netkot/EQ2_mount/Pinout-of-Circuit-TMC2209.webp

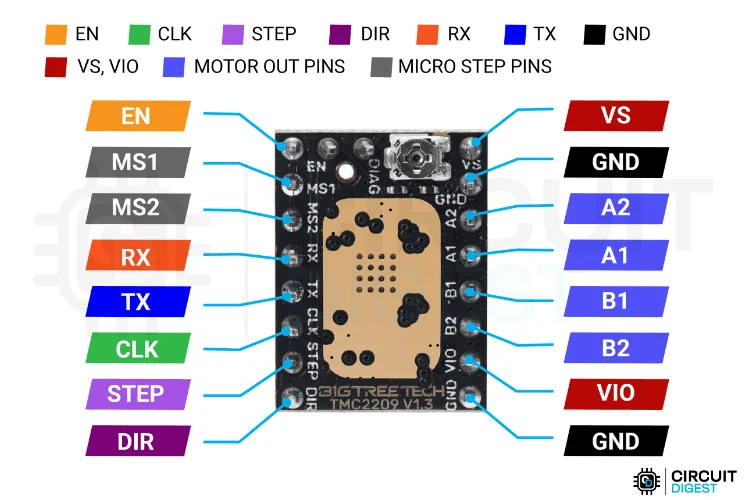
Pinout-of-Circuit-TMC2209.webp
