netkot/EQ2_mount/photo_2026-08-16_16-16-36.jpg

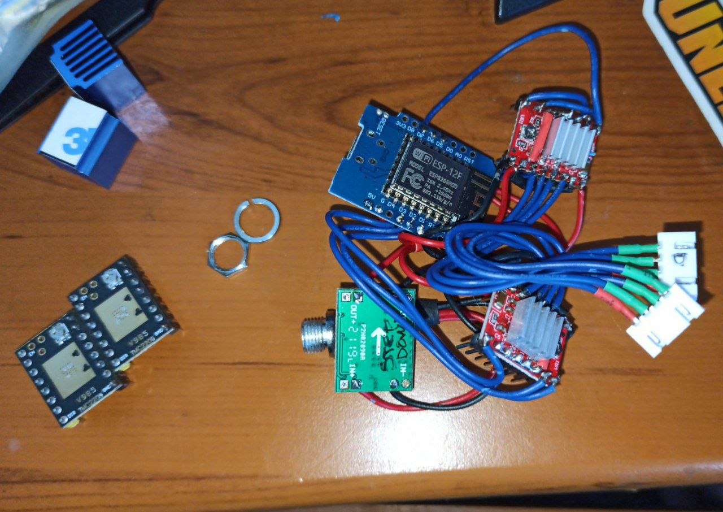
photo_2026-08-16_16-16-36.jpg
