netkot/EQ2_mount/HALL_SENSOR_DEC_HOME.md

# Датчик Холла A3144 — метка парковки по оси DEC

Цифровой датчик Холла отмечает положение оси DEC в **зоне парковки**. По нему прошивка
сама находит, где стоит ось, и поправляет счётчик DEC: после включения, после
сдвига оси рукой и т. п. Разделы 1–7 описывают железо, раздел 8 — прошивку.

Магнит стоит не в Home (труба на полюс, DEC = 90°), а в положении парковки:
механический DEC середины зоны 71.00° (калибровка 2026-10-31 по Sync на антенну).

**Датчик:** маркировка «3144 / 402». Это A3144 (Allegro или клон), а «402» — код
партии или даты. Тип: цифровой, униполярный, выход «открытый коллектор».

---

## 1. Выбор пина ESP8266

Занятые пины прошивки:

| GPIO | NodeMCU | Назначение |
|---|---|---|
| 4, 5, 0 | D2, D1, D3 | RA STEP / DIR / EN |
| 12, 14, 13 | D6, D5, D7 | DEC STEP / DIR / EN |
| 2 | D4 | TMC2209 UART |

Свободные пины:

| GPIO | NodeMCU | Годится? | Почему |
|---|---|---|---|
| **16** | **D0** | **Да, основной вариант** | Не участвует в загрузке и ни с чем не делит линию |
| 3 | RX | Да, запасной вариант | Есть `INPUT_PULLUP` и прерывания, но на линии висит USB-UART |
| 15 | D8 | **Нет** | Бут-пин: при старте должен быть LOW, а подтянутый датчик даёт HIGH, и плата не загрузится |
| A0 | A0 | Нет | Аналоговый вход, нужен только для линейного датчика (49E) |

### Особенности GPIO16 (D0)

- **Внутренней подтяжки к питанию нет.** GPIO16 относится к RTC-блоку и умеет только
  подтяжку к земле (`INPUT_PULLDOWN_16`). Вызов `pinMode(16, INPUT_PULLUP)` ядро
  Arduino просто игнорирует, и вход остаётся висящим в воздухе.
  **Поэтому внешний резистор 10 кОм к 3.3 V обязателен.** В коде пин настраивается как `pinMode(16, INPUT)`.
- **Прерываний нет.** Пин опрашивается в `loop()`. Этого достаточно: края зоны
  замеряются на 1°/с ≈ 44 шаг/с. Задержка `loop()` ошибки не даёт: мотор шагает из
  того же `loop()` и на время задержки тоже стоит.
- На некоторых NodeMCU к D0 подключён светодиод (возле USB, анод через резистор на
  3.3 V). Он слегка подтягивает линию вверх и загорается при срабатывании датчика,
  что удобно для отладки. Подтяжку он **не заменяет**, а на части плат его нет.

### Если всё же RX (GPIO3)

- Внешний резистор не нужен: `pinMode(3, INPUT_PULLUP)`.
- В прошивке перевести UART в режим только передачи:
  `Serial.begin(115200, SERIAL_8N1, SERIAL_TX_ONLY)`. Прошивка обновляется по OTA,
  поэтому приём по UART не нужен.
- При подключённом USB чип USB-UART держит RX в HIGH через 470 Ом. Датчик это
  перетянет (ток около 7 мА, A3144 выдерживает до 25 мА), но схема менее чистая.

---

## 2. Цоколёвка A3144 (TO-92)

Датчик держать скошенной стороной с надписью к себе, ножками вниз:

```
      ┌─────────┐
      │  3144   │
      │  402    │
      └─┬──┬──┬─┘
        1  2  3
       VCC GND OUT
```

---

## 3. Схема подключения

```
   +5V (Vin NodeMCU) ──┬──── 1 VCC
                       │
                    100 нФ   (у самого датчика)
                       │
   GND ────────────────┴──── 2 GND

                             3 OUT ──┬─────────┬──── D0 (GPIO16)
                                     │         │
                                  10 кОм     100 нФ  (у ESP, по желанию)
                                     │         │
                                   3.3V       GND
```

| Ножка | Куда |
|---|---|
| 1 VCC | +5 V (Vin NodeMCU) |
| 2 GND | GND |
| 3 OUT | D0 (GPIO16) и резистор 10 кОм к **3.3 V** |

### Важно

- [ ] **Питание датчика: 5 V, не 3.3 V.** A3144 работает от 4.5–24 V. От 3.3 V
      он либо не включится, либо будет срабатывать нестабильно.
- [ ] **Подтяжка: только к 3.3 V, не к 5 V.** Выход с открытым коллектором сам
      напряжение не выдаёт, он только замыкает линию на землю. Уровень HIGH задаёт
      резистор, и при подтяжке к 3.3 V на пин ESP 5 V не попадёт. ESP8266 официально не рассчитан на 5 V на входе.
- [ ] **Все конденсаторы 100 нФ керамические**, не электролитические: маркировка «104»
      (советская «Н1», «М1» или «0,1»), напряжение от 16 V. Полярности у них нет.
      Электролит на высоких частотах плохо давит помехи. Допустим разброс 47–220 нФ.
      При длинном проводе питания можно добавить у датчика электролит 10–47 мкФ / 16 V
      параллельно керамике (плюс к VCC). Керамику 100 нФ при этом не убирать.
- [ ] Конденсатор 100 нФ VCC–GND ставить прямо у датчика.
- [ ] Конденсатор 100 нФ OUT–GND у ESP нужен, если провод длинный или идёт рядом с
      проводами моторов (ШИМ драйверов TMC2209 наводит помехи).
- [ ] Для длинного провода лучше витая пара или экран: OUT в паре с GND. Не вести
      его в одном жгуте с фазами моторов.

### Длина провода

Скорость сигнала тут не важна: датчик переключается редко, а провод ёмкостью около 100 пФ/м
с подтяжкой 10 кОм даёт фронт в единицы микросекунд даже при 3 м. Падение напряжения
питания тоже не проблема, датчик потребляет около 5 мА. Ограничивают длину только
**наводки от моторов** и шум по земле.

| Длина | Что нужно |
|---|---|
| до 1 м | Обычные провода, схема как выше. На монтировке обычно столько и нужно |
| 1–3 м | Витая пара (OUT + GND), конденсатор 100 нФ OUT–GND у ESP обязателен, подтяжку уменьшить до 4.7 кОм |
| 3–5 м | Экранированный кабель (экран на GND только со стороны ESP), подтяжка 2.2–4.7 кОм, RC-фильтр: 1 кОм последовательно в OUT перед D0 и 100 нФ на землю у ESP |
| больше 5 м | Не рекомендуется: нужна гальваническая развязка (оптрон) или датчик ближе к плате |

**Какой кабель.** Для 1–1.5 м подходит обычный телефонный:
- **Плоская «лапша», 4 жилы:** подходит. Она гибкая, многопроволочная и нормально
  переносит изгибы при вращении RA. Порядок жил: `OUT – GND – VCC – GND`, то есть
  сигнал рядом с землёй, а четвёртая жила тоже на GND (обе земли спаять на обоих концах).
- **Витая пара (UTP cat3/cat5):** подходит и защищает от помех лучше (OUT + GND в одной
  паре, VCC + GND в другой). Но жилы у неё обычно однопроволочные: на подвижном
  участке они ломаются от изгибов. Её стоит брать для неподвижной прокладки или
  в многопроволочном варианте (патч-корд).
- **Витой шнур трубки:** не годится. Жилы из мишурной нити, их трудно паять, и они рвутся.
- Жилы бывают из омеднённого алюминия (CCA): их сложно паять. Медь видна по цвету на срезе.

Ещё два правила:
- Провод датчика не вести в одном жгуте с фазами моторов. Если пересекаются, то под прямым углом.
- Программный антидребезг в прошивке: срабатыванием считается уровень, который
  продержался 5 мс (`HALL_DEBOUNCE_MS`).

### Логика

| Состояние | Уровень на D0 |
|---|---|
| Магнита нет | HIGH (около 3.3 V) |
| Южный полюс у датчика | **LOW** (около 0.1–0.2 V) |

Логика инверсная: срабатывание даёт `digitalRead(16) == LOW`.

---

## 4. Если датчик на платке модуля (KY-003 и подобные)

У модулей со светодиодом и тремя штырьками на плате часто стоит своя подтяжка OUT→VCC
(10 кОм). При питании модуля от 5 V на D0 тогда придёт **5 V**.

- [ ] Мультиметром (режим сопротивления, без питания) проверить, есть ли резистор
      между OUT и VCC модуля.
- [ ] Если есть: **выпаять его** и поставить свою подтяжку 10 кОм к 3.3 V по схеме
      выше. Другой вариант — делитель на выходе: 10 кОм последовательно и 20 кОм на землю.
- [ ] Светодиод модуля можно оставить. Он висит со стороны VCC и линию не портит.
- [ ] Питать модуль от 3.3 V нельзя: на нём тот же A3144 (минимум 4.5 V).

---

## 5. Механика: магнит и крепление

- **Магнит:** неодимовый, около 5×2 мм (диск). Крепится на **вращающуюся** часть
  оси DEC (большую шестерню, фланец или ось), датчик — на **неподвижный** корпус.
- **Полярность:** A3144 униполярный и срабатывает **только от южного полюса**,
  направленного на сторону корпуса с надписью. Северный полюс он не видит.
  Если реакции нет, переверните магнит.
- **Зазор:** 2–4 мм. С магнитом 5×2 мм датчик уверенно срабатывает примерно до 3–5 мм.
  Ближе — надёжнее, но не допускать касания при люфте оси.
- **Положение:** датчик срабатывает в **положении парковки**. Механический DEC середины
  зоны — метка, хранится во флеше и измеряется калибровкой (раздел 8). Магнит можно
  ставить в любое положение: после перестановки достаточно заново откалибровать метку.
- **Зона срабатывания:** у датчика гистерезис включения и выключения, поэтому зона
  широкая. На EQ2 она вышла **около 21.5°** по оси DEC (вход около 60.6°, выход около 82.2°
  механически). Точность задаётся не размером зоны, а методикой поиска: середина между
  краями (разделы 6 и 8). Повторяемость середины — около 0.1°.
- **Ось DEC проходит 360°,** и магнит встречается один раз за оборот. Положение
  внутри одного оборота определяется однозначно. Но с какой стороны искать магнит
  и на каком обороте ось (перекрутка кабелей), один датчик не скажет: см. раздел 6.
- Магнит закрепить надёжно (эпоксидка или цианакрилат в выборке), чтобы он не
  сместился: иначе уплывёт метка.
- Рядом с датчиком не должно быть стальных деталей, которые искажают поле, и других магнитов.
- Мотор DEC (шаговый, с постоянными магнитами) держать подальше от датчика: хотя бы
  на 3–4 см.

### Ориентация датчика и магнита

Датчик реагирует только на поле, которое входит в его **плоскую сторону с надписью**,
и только на **южный полюс**. Поэтому магнит должен проходить мимо этой стороны,
глядя на неё южным полюсом.

**Датчик:**
- Чувствительный элемент находится под надписью, примерно в центре корпуса и на глубине
  около 0.5 мм от лицевой стороны.
- Сторона с надписью смотрит на путь магнита. Скошенная задняя сторона смотрит от магнита.
- Как повернуть корпус вокруг этой оси (ножками вдоль движения или поперёк), почти не важно.
  Удобнее ставить ножками поперёк движения: тогда магнит проходит над центром корпуса.

**Магнит:** обычный диск намагничен по оси, то есть его полюса находятся на плоских сторонах.
Значит, к датчику он должен быть обращён **плоской стороной, южным полюсом**, а не ребром.

**Монтаж на оси DEC: магнит проходит мимо датчика.** Магнит движется параллельно лицевой
стороне датчика, а не надвигается на неё в лоб. Подойдут два варианта:

```
 А) Магнит на торце шестерни/фланца       Б) Магнит на ободе (по радиусу)

      ось DEC                                    ось DEC
        │                                           │
   ═════╪═════  ← шестерня                     ┌────┴────┐
        │   [S]  ← магнит, S к датчику         │    ●    │ ← фланец
        │  ─────  зазор 2–3 мм                 └───[S]───┘ ← S наружу
        │  [▓▓▓]  ← датчик, надпись к магниту       ───    зазор
        │                                          [▓▓▓]   ← надпись к оси
```

- **А (торец):** магнит вклеен в торец шестерни или фланца, датчик стоит параллельно
  торцу. Проще выдержать зазор, если у оси нет осевого люфта.
- **Б (обод):** магнит на цилиндрической поверхности, датчик смотрит на ось. Зазор
  зависит от радиального биения.

Выбирайте тот вариант, где у оси меньше люфта именно в направлении зазора.

**Как найти южный полюс:**
- **Компасом:** поднесите магнит к компасу. Сторона магнита, к которой повернулся
  **северный** конец стрелки, и есть **южный** полюс. Пометьте её маркером.
- **Самим датчиком:** поднесите магнит одной стороной. Если `Hall` не меняется,
  переверните магнит.

**Проверка после установки:** проверните ось рукой через зону. Датчик должен включаться
и выключаться один раз за проход, без дрожания на краях (поле `hall_edges` в `/status`
растёт ровно на 2).

---

## 6. Сторона подхода, направление поиска и перекрутка на 360°

Датчик выдаёт один бит: «магнит рядом» или «нет». Ни направления движения, ни номера
оборота он не знает. Всё это прошивка берёт из своих данных.

### С какого края зоны подошли

Прошивка сама крутит мотор, поэтому в момент срабатывания знает направление
движения (знак скорости, пин DIR) и текущий счётчик шагов. Стороной подхода не нужно
«узнавать» — её надо **выбирать**. Методика:

1. Если при старте датчик уже LOW, выйти из зоны (например, в сторону `−`).
2. Медленно ехать в `+`. Шаг, на котором HIGH → LOW, — край A.
3. Проехать зону насквозь. Шаг, на котором LOW → HIGH, — край B.
4. Метка = (A + B) / 2.

Середина зоны не зависит от гистерезиса и от силы магнита, поэтому она повторяема.

### В какую сторону ехать искать

Это и есть настоящая неоднозначность: из произвольного положения до магнита можно
ехать в обе стороны, и сам датчик не подскажет, какая ближе. Варианты:

| Способ | Как работает | Минусы |
|---|---|---|
| **Подсказка по счётчику** (сделано) | Счётчик DEC после включения берётся из парковки во флеше. Ехать к метке и не дальше 30° за неё | Если ось провернули рукой, подсказка неверна → поиск не найдёт магнит в окне и остановится с ошибкой |
| Расширяющееся окно | ±N° в одну сторону, затем в другую, N растёт до предела | Медленно, но кабели не накрутятся |
| Флажок на 180° | Датчик видит «да» на половине оборота и «нет» на другой половине. Уровень сразу говорит, в какой половине оборота труба и куда ехать; метка — граница половин | Нужна дуга из магнитов или оптический щелевой датчик с полукруглым флажком |
| Две метки | Второй магнит или второй датчик под другим углом, как у квадратурного энкодера | Сложнее механика и прошивка |

### Перекрутка на 360°

**Один датчик полные обороты не различает в принципе.** При DEC = 71° и при 71° + 360°
труба физически стоит одинаково, разница только в том, как намотаны кабели. Защита:

- [ ] **Программный лимит механического DEC** — меньше 360° вокруг метки, например
      ±180°. GoTo и джог за пределы не выпускать. Пока прошивка непрерывно считает шаги,
      номер оборота однозначен.
- [x] **Положение DEC во flash** — это парковка: после перезагрузки счёт
      продолжается с неё.
- [x] **Окно поиска меньше 360°**: не дальше 30° за ожидаемую метку, чтобы при отказе
      датчика ось не сделала лишний оборот.
- [ ] Если ось провернули рукой при отпущенном фиксаторе или на выключенной монтировке, никакой
      датчик этого не увидит. Здесь нужен механический упор или визуальная проверка
      кабелей перед поиском.

**Для EQ2 сделано:** точечный магнит в зоне парковки, парковка во flash как подсказка,
поиск к метке с окном 30° за неё, середина по двум краям зоны. Программного лимита
±180° пока нет. Флажок на 180° нужен, только если нужен поиск «с нуля» без подсказки.

---

## 7. Проверка до прошивки

1. Подключить датчик по схеме, подать питание.
2. Мультиметром на D0 относительно GND:
   - без магнита — около **3.3 V**;
   - южным полюсом к надписи вплотную — около **0.1–0.2 V**.
3. Если всегда 3.3 V: проверить полярность магнита, питание 5 V на ножке 1 и
   цоколёвку (не перепутаны ли 1 и 3).
4. Если всегда около 0 V или напряжение плавает: нет подтяжки к 3.3 V или ошибка в схеме.
5. Если без магнита около 5 V: подтяжка идёт к 5 V (модуль, раздел 4). **Сразу отключить.**
6. Покрутить ось DEC вручную и убедиться, что в зоне парковки напряжение падает в LOW.

---

## 8. Прошивка

### Датчик

- `#define DEC_HOME_PIN 16`, `pinMode(DEC_HOME_PIN, INPUT)`: подтяжка внешняя.
- Антидребезг 5 мс; каждое переключение пишется в Serial вместе с механическим DEC.
- Поля в `/status`:

| Поле | Что значит |
|---|---|
| `hall` | 1 — магнит у датчика (после антидребезга) |
| `hall_raw` | мгновенный уровень на пине (1 = LOW) |
| `hall_edges` | число переключений с момента загрузки |
| `hall_in` / `hall_out` | механический DEC при последнем входе в зону и выходе из неё |
| `mech_dec` | текущий механический DEC |
| `hall_mark` | метка: механический DEC середины зоны |
| `homing` | этап поиска: 0 — нет, 1 — быстрый подход, 2 — отъезд из зоны, 3 — замер краёв, 4 — доезд в середину |
| `home_msg` | результат последнего поиска |

- В строке статуса веб-интерфейса: «Hall: MAGNET / clear (число переключений)» и
  «Датчик: …» с результатом поиска.

### Поиск метки

`GET /home-search[?dir=1|-1][&calibrate=1]`, кнопки «🧲 Привязка по датчику» и
«🧲 Калибровать метку» в карточке GoTo/Sync.

1. Направление — к метке по текущему счётчику DEC (`dir` задаёт его вручную). Из положения
   ниже метки по N-стороне это DEC+: труба поднимается.
2. Быстро (6°/с) до входа в зону. Не дальше 30° за метку, иначе ошибка
   «магнита нет в окне поиска».
3. Назад из зоны и ещё на 3° (если при старте датчик уже видит магнит — сразу этот этап).
4. Медленно (1°/с) насквозь через зону: край A на входе, край B на выходе.
   Середина = (A + B) / 2. Зона шире 30° — ошибка.
5. **Привязка:** счётчик DEC сдвигается так, чтобы середина стала равна метке.
   **Калибровка:** счётчик верен (только что был Sync), середина сохраняется во флеш
   как новая метка. В обоих случаях ось доезжает в середину зоны.

RA поиск не трогает. Stop, джог, Sync и E-Stop прерывают поиск. Метка по умолчанию —
`HALL_MARK_DEFAULT` (71.10°); калибровка записывает её во флеш (EEPROM, адрес 32,
после парковки).

### Порядок работы

- **Один раз (и после перестановки магнита):** Sync на антенну или звезду →
  «Калибровать метку» → Set Park (труба стоит на метке, парковка = метка).
- **Перед выключением:** Park, ось уходит на метку.
- **После включения:** счётчики берутся из парковки. «Привязка по датчику» поправит
  DEC, если ось сдвинулась. RA датчик не проверяет.

### Пока не сделано

- Программный лимит механического DEC ±180° от метки (раздел 6).
- Команды LX200 (`:hC#` и т. п.) для поиска метки.
