netkot/EQ2_mount/images/s-l1600.jpg

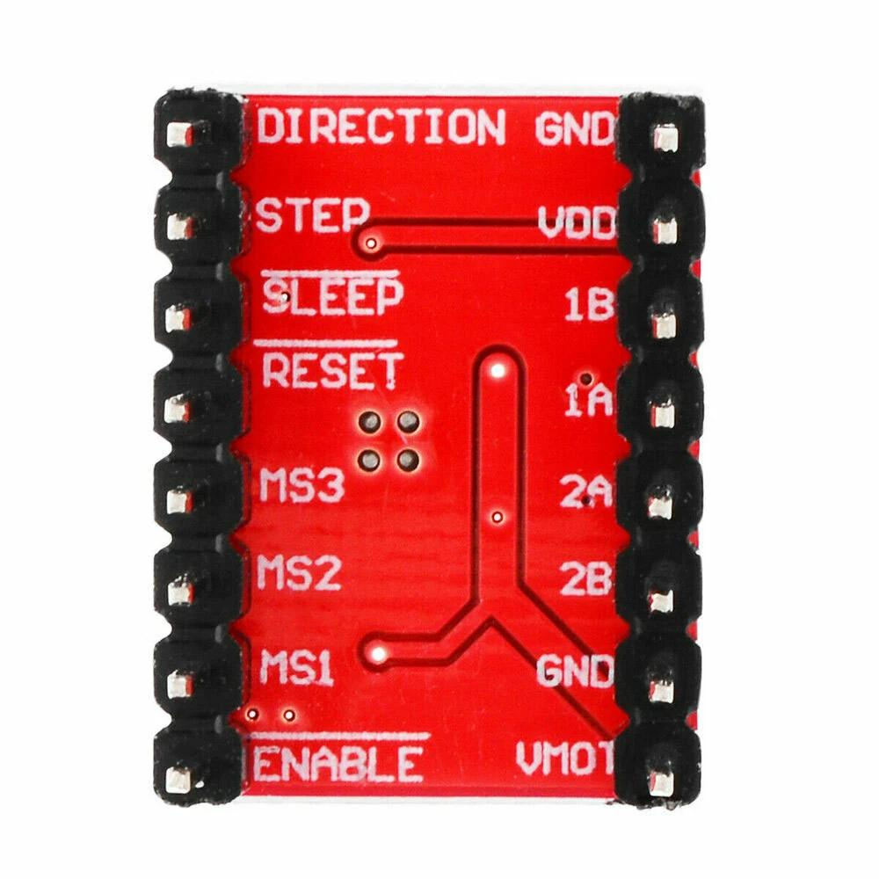
images/s-l1600.jpg
