netkot/EQ2_mount/images/screenshot 2026-08-16 212933.jpg

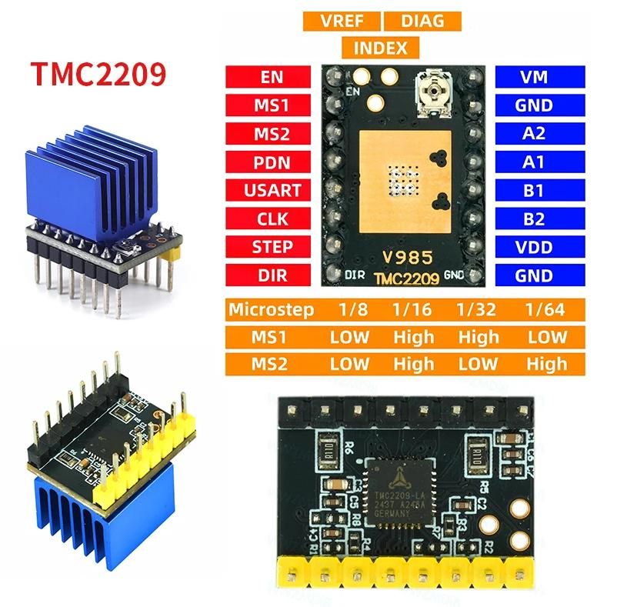
images/screenshot 2026-08-16 212933.jpg
