netkot/EQ2_mount/TMC2209_SOLDERING.md

# Перепайка A4988 → TMC2209 — пошаговая инструкция

Сопутствует разделу «План перехода на TMC2209» в `README.md`. Здесь — физика пайки:
какой провод со старого драйвера куда переносится на новый.

**Статус на 2026-10-17:** обе оси перепаяны и проверены (UART, ток, вращение моторов).

Распиновка платы ниже — **точная, с фото/схемы конкретно этой платы**
(«TMC2209», партия «V985», чип `TMC2209-LA`), а не обобщённая по формату Pololu.

---

## 0. Перед началом (обязательно)

- [ ] Полностью обесточить сборку — отключить 12V **и** USB/питание ESP. Не работать
      под напряжением.
- [ ] Сфотографировать текущую распайку каждого A4988 до разборки (на случай отката).
- [ ] Работать **по одной оси за раз**: полностью перенести RA, проверить, только
      потом браться за DEC — так нельзя перепутать, какой провод откуда.
- [ ] Свериться с маркировкой резистора Rsense на новой плате (должен быть 0.11 Ω,
      встречаются 0.1/0.15 Ω — влияет на формулу VREF/тока, см. README).

---

## Итоговая схема: Пин ESP → Пин драйвера (справочно)

Собранная в одном месте выжимка из разделов ниже — просто «откуда куда идёт провод».
Детали, объяснения и оговорки — в соответствующих разделах (2–4) по ссылкам в скобках.

### Сигнальные пины (STEP/DIR/EN) — по одному на ось, не общие

| Пин ESP (GPIO)  | Сигнал | Куда на драйвере |
|---|---|---|
| D2 (GPIO4) | STEP RA  | STEP на RA-драйвере |
| D1 (GPIO5) | DIR RA | DIR на RA-драйвере |
| D3 (GPIO0) | EN RA | EN на RA-драйвере (активный уровень — LOW) |
| D6 (GPIO12) | STEP DEC | STEP на DEC-драйвере |
| D5 (GPIO14) | DIR DEC  | DIR на DEC-драйвере |
| D7 (GPIO13) | EN DEC | EN на DEC-драйвере (активный уровень — LOW) |

### UART-шина — общая на оба драйвера (п.4.1)

| Пин ESP (GPIO) | Куда | Комментарий |
|---|---|---|
| D4 (GPIO2, RX+TX) | PDN на RA **и** PDN на DEC (общий узел) | через резистор **1 кΩ**, стоящий один раз до разветвления |
| D8 (GPIO15) | **никуда** | ⚠️ не подключать — ESP перестаёт загружаться (п.4.1) |

`USART`-пин на обеих платах никуда не подключается (см. п.4.1 — прозвонкой подтверждено,
что он не связан с PDN_UART на этой плате).

### Питание логики (VDD) и земля — общие на оба драйвера

| Откуда | Куда |
|---|---|
| 3.3V (даёт плата ESP-12F) | VDD на RA-драйвере и VDD на DEC-драйвере |
| GND (любой GND ESP) | GND (логический, рядом с VDD) на RA и на DEC |

⚠️ Не 5V — see п.3 в README и п.0/3 ниже, у ESP-12F логика 3.3V.

### Силовое питание (12V) — не через ESP, напрямую с рельса 12V

| Откуда  | Куда |
|---|---|
| 12V+ | VM на RA-драйвере и VM на DEC-драйвере |
| 12V GND  | GND (силовой, рядом с VM) на RA и на DEC |

### Перемычки на самой плате драйвера (не идут к ESP вообще)

Это не провода к ESP, а короткие перемычки прямо на плате каждого драйвера — упомянуты
здесь, чтобы схема была полной:

| Что | RA-драйвер | DEC-драйвер |
|-----|---|---|
| CLK | → GND (свой, на плате) | → GND (свой, на плате) |
| MS1 | → GND (адрес 0) | → VDD/3.3V (адрес 1) |
| MS2 | → GND (адрес 0) | → GND (адрес 1) |

Обмотки мотора (A1/A2/B1/B2) идут к мотору, а не к ESP — см. таблицу переноса в п.3.

---

## 1. Логическая схема A4988 (что перенести)

```
              A4988 (типовая схема функций Pololu-формата)
        ┌───────────────────────────┐
  EN ───┤ ENABLE            VDD     ├─── VDD (логика, обычно 3.3–5V — проверить!)
 MS1 ───┤ MS1               GND     ├─── GND (логика)
 MS2 ───┤ MS2               2B      ├─── обмотка мотора, конец 2B
 MS3 ───┤ MS3               2A      ├─── обмотка мотора, конец 2A
 RST ───┤ RESET             1A      ├─── обмотка мотора, конец 1A
 SLP ───┤ SLEEP             1B      ├─── обмотка мотора, конец 1B
STEP ───┤ STEP              VMOT    ├─── VMOT (12V, силовое питание мотора)
 DIR ───┤ DIR               GND     ├─── GND (силовой)
        └───────────────────────────┘
```

MS1/MS2/MS3/RESET/SLEEP на A4988 сейчас, скорее всего, либо не задействованы
(NC/подтянуты по умолчанию), либо запаяны в конкретное положение под полношаговый/
микрошаговый режим — эти провода **не переносим**, они на TMC2209 получают другой
смысл (см. ниже).

## 2. Точная схема этой платы TMC2209 (V985)

```
                     ┌───────┬───────┬───────┐
                     │ VREF  │ DIAG  │       │   (VREF — подстроечник, DIAG/INDEX — доп. пины)
                     └───────┴───┬───┴───────┘
                            INDEX│
        ┌────────────────────────┴─────────────────────┐
  EN ───┤ EN                                        VM ├─── VM (VMOT, 12V)
 MS1 ───┤ MS1 (адрес, бит0 в UART-режиме)          GND ├─── GND (силовой)
 MS2 ───┤ MS2 (адрес, бит1 в UART-режиме)           A2 ├─── обмотка мотора, катушка A (конец 2)
 PDN ───┤ PDN   ─┐  (см. п.4.1 — соединить          A1 ├─── обмотка мотора, катушка A (конец 1)
USART ──┤ USART ─┘   с USART перемычкой)            B1 ├─── обмотка мотора, катушка B (конец 1)
 CLK ───┤ CLK  → на GND (внутренний генератор)      B2 ├─── обмотка мотора, катушка B (конец 2)
STEP ───┤ STEP                                     VDD ├─── VDD (логика — ОБЯЗАТЕЛЬНО 3.3V!)
 DIR ───┤ DIR                                      GND ├─── GND (логика)
        └──────────────────────────────────────────────┘
```

Легенда с шелкографии платы (легаси-режим микрошага, актуален **только пока UART
не поднят** — после инициализации UART MS1/MS2 становятся адресными битами, а не
настройкой микрошага, см. п.4.2):

| Microstep | 1/8 | 1/16 | 1/32 | 1/64 |
|---|-----|---|---|---|
| MS1 | LOW | High | High | LOW  |
| MS2 | LOW | High | LOW  | High |

---

## 3. Таблица переноса «провод → провод»

| Провод (по факту в жгуте) | Со старого A4988 | На новый TMC2209 | Действие |
|---|---|---|---|
| Синий сигнальный (STEP) | STEP | STEP | 1:1 |
| Синий сигнальный (DIR) | DIR | DIR | 1:1 |
| Синий сигнальный (ENABLE) | ENABLE | EN | 1:1 |
| Красный (силовой, 12V) | VMOT | VM | 1:1 |
| Чёрный (силовой, рядом с VMOT) | GND (силовой) | GND (силовой, рядом с VM) | 1:1 |
| Зелёные JST-пары (обмотки мотора)  | 1A/1B/2A/2B (или разъём) | A1/A2/B1/B2 (или разъём) | Если на новой плате есть такой же JST-разъём, просто переставить разъём; если голые контактные площадки — впаять провода от мотора напрямую. **Полярность внутри пары (A1↔A2, B1↔B2) не критична — направление вращения потом правится в коде/DIR, а не перепайкой.** ⚠️ А вот **пары** проверять обязательно на выводах драйвера (п.6) — порядок контактов разъёма не обязан совпадать с порядком A2/A1/B1/B2. |
| Провод логического питания (VDD) | VDD | VDD | ⚠️ Переносить **только если источник провода 3.3V**. Если раньше шёл от 5V-рельса — перекинуть исток на 3.3V (у ESP-12F плата даёт 3.3V логику) |
| Чёрный (логический GND) | GND (логика) | GND (логика, рядом с VDD) | 1:1 |

MS1/MS2/MS3/RESET/SLEEP старого A4988 — эти провода никуда не переносим
(остаются неиспользованными/удаляются). На новой плате MS1/MS2 используются
заново под адресацию (п.4.2), CLK и PDN/USART — новые провода (п.4).

---

## 4. Новые провода (которых на A4988 не было)

### 4.1 UART-шина (общая для RA и DEC, однопроводная)

На этой плате PDN_UART выведен **двумя соседними пинами — `PDN` и `USART`**.
Проверено мультиметром (прозвонка/сопротивление, питание снято) — между `PDN` и
`USART` **нет связи («OL»)**, пины независимы. Вывод: `USART` в разводке этой
платы не подключён к сигналу PDN_UART (либо задействован под что-то иное/не
разведён вовсе). Используем только **`PDN`** как рабочий контакт UART, `USART`
никуда не подключаем.

⚠️ Проверено пока на одной плате — перед пайкой **второй** платы (RA/DEC — какая
из них уже проверена, стоит уточнить) стоит повторить прозвонку `PDN`↔`USART` и
на ней, на случай если платы из разных партий разведены по-разному.

Поскольку своего резистора на плате в этом случае нет, внешний резистор 1кΩ между
ESP и узлом — обязателен. ESP и передаёт, и принимает одним пином D4:

```
                                    ┌── PDN (RA-драйвер,  addr 0)
ESP D4 (GPIO2) ────[резистор 1кΩ]───┤
                                    └── PDN (DEC-драйвер, addr 1)

ESP D8 (GPIO15) — не подключён
```

- Резистор 1кΩ стоит один раз, между D4 и общим узлом.
- Оба драйвера (RA и DEC) висят на одном общем узле шины — на пине `PDN` каждого.
- `USART` на обеих платах остаётся неподключённым.
- ⚠️ **D8 к узлу не подключать.** В первой версии схемы RX шёл с D8 прямо на узел — узел
  подтянут вверх, GPIO15 при старте оказывался в HIGH, и ESP не загружался
  (`boot mode:(7,0)` / `waiting for host` в логе на 74880 бод, esptool не подключается).
  Если такое повторится — первым делом проверить, что D8 свободен.

Также обязательно **CLK → GND** на каждом драйвере (новый провод) — иначе пин
клока не определён и чип не запустится штатно на внутреннем генераторе.

### 4.2 Адресация MS1/MS2 (статическое подтягивание, отдельно на каждом драйвере)

| Драйвер | MS1 | MS2  | Адрес UART |
|---|---|---|---|
| RA | → GND | → GND | 0 |
| DEC | → VDD (3.3V) | → GND | 1 |

Это отдельные короткие перемычки на каждой плате TMC2209 (не идут к ESP напрямую).
Действуют только после инициализации UART — до этого MS1/MS2 = легаси-таблица
микрошага из п.2.

---

## 5. Порядок работы по оси (повторить для RA, затем для DEC)

1. [ ] Обесточить сборку.
2. [ ] Сфотографировать распайку старого драйвера этой оси.
3. [ ] Перепаивать **по одному проводу за раз** (отпаял → сразу припаял на новое
       место по таблице п.3) — не отпаивать всё разом, чтобы не перепутать провода
       между собой.
4. [ ] Проверить провод VDD отдельно — источник должен быть 3.3V, не 5V.
5. [ ] Если это вторая плата (ещё не прозванивалась) — прозвонить `PDN`↔`USART`
       мультиметром до пайки (п.4.1), убедиться что тоже «OL», как на первой.
6. [ ] Впаять перемычку `CLK`→`GND` на плате драйвера (п.4.1).
7. [ ] Добавить провод UART-шины от ESP D4 на пин `PDN` (п.4.1, резистор 1кΩ, D8 не трогать) —
       можно сразу развести общий узел на оба драйвера, даже если второй ещё не перепаян.
8. [ ] Добавить перемычки адреса MS1/MS2 (п.4.2) — GND/GND для RA, VDD/GND для DEC.
9. [ ] Если это тот драйвер, под который выделен запасной радиатор — приклеить его.
10. [ ] Прозвонить мультиметром **до подачи питания** (см. п.6 ниже).

---

## 6. Финальная проверка перед первым включением

Прозвонить мультиметром в режиме «прозвонка/сопротивление» (питание выключено!):

- [ ] Нет короткого VM ↔ GND.
- [ ] Нет короткого VM ↔ VDD.
- [ ] Нет короткого VDD ↔ GND.
- [ ] STEP/DIR/EN не закорочены на VM или на GND.
- [ ] VDD действительно приходит с 3.3V-рельса, не с 5V.
- [ ] MS1/MS2 каждого драйвера подтянуты согласно таблице в п.4.2 (не висят в воздухе).
      После включения проверить вольтметром относительно GND драйвера: у RA MS1 = 0 В,
      MS2 = 0 В; у DEC **MS1 = 3.3 В**, MS2 = 0 В. На DEC MS1 сначала оказался на 0 —
      оба драйвера отвечали по адресу 0 и мешали друг другу (README п.6, «Конфликт адресов»).
- [ ] CLK подтянут к GND (не висит в воздухе).
- [ ] Обмотки мотора не перепутаны между парами. Мерить **на выводах драйвера** с
      подключённым через разъём мотором: A1–A2 и B1–B2 ≈ сопротивление фазы
      (RA JK42HS40 ≈ 1.5–1.65 Ом, DEC JK42HS60 ≈ 6 Ом), A1–B1 — обрыв. Если пары
      перекрёстные — мотор дёргается на месте, а не вращается; лечится перестановкой
      двух средних проводов (A1 ↔ B1). Так было на RA: на разъёме мотора пары были
      правильными, а провода от разъёма к драйверу (все синие) перекрестились.
- [ ] Электролит **100 мкФ / ≥25 В** на VM–GND прямо у драйвера (полярность!). Без него
      драйвер может сбрасываться при включении мотора (видно по `/tmc`, см. README п.6).
- [ ] D8 ни к чему не подключён.

Первое включение — подавать питание аккуратно, держать руку на отключении первые
секунды. Мотор подключать и отключать **только при снятом 12V**.

Проверка после включения (прошивка уже с `TMCStepper`, см. README п.5–6):

1. Лог USB на 115200: `TMC RA: OK, версия 0x21, микрошаг 1/16, ток 1160 мА` (для DEC —
   `TMC DEC: OK …`, ток 840 мА). `нет ответа` — проверить D4, резистор, PDN, MS1/MS2.
   Без USB — `/status` (`ra_drv` / `dec_drv`) и `/tmc`. Если драйвер не отвечает —
   `/tmc-scan` покажет, кто на каком адресе и не закорочена ли линия.
2. Короткий jog на 0.1°/с (`/jog?axis=ra&speed=0.1`, стоп — `/stop-all`). `/tmc` читать
   до и после движения: `microsteps` должен оставаться 16, `ifcnt` — не меняться. Опрос
   `/tmc` во время движения сам вызывает рывки мотора — для проверки плавности не годится.
3. Мотор должен вращаться ровно и почти бесшумно (StealthChop).
