netkot/EQ2_mount/OneStep_Full_ESP8266_v6.ino

// ============================================================
//  EQ2 Mount Controller  —  v6.0
//  ESP8266 NodeMCU
//
//  Протоколы:
//    • Web UI        http://<IP>/
//    • RTS2 JSON API http://<IP>/api/...   (Stellarium)
//    • LX200/OnStep  TCP <IP>:4030         (KStars, PHD2, Cartes du Ciel)
//    • OTA update    http://<IP>/update
//
//  Изменения v6 vs v5:
//    • LX200/OnStep команды приведены в полное соответствие
//      с lx200driver.h (INDI) и OnStepListCmd.txt
//    • Добавлены: :ACK (0x06), :GX0n#, :GX4n#, :GX9n#,
//      :GX91#, :GXS#, :GXU#, :SXA#, :GXGA#, :GXGO#,
//      :GX98# (rotator none), PEC-заглушки :VH# :VR# :VS# :VW#,
//      Library-заглушки :LI# :LR# :LB# :LN# :LC# :LD# :LL# :Lo#,
//      :Rotator-заглушки :rA# и прочие :r*#
//    • Исправлены форматы ответов :GU# :Gu# :GW# per lx200driver
//    • :GT# → "60.1642#" когда трекинг включён, "0.0000#" иначе
//    • :D#  → "\x7f#" / "#" (per spec "\0x7f#")
//    • DEC мотор не отключается после остановки (держит ось)
//
//  v6.1: модель координат RA = LST − HA (NTP), стороны опоры,
//        GoTo с доводкой, трекинг/джог отделены от run() — см. README
// ============================================================

#include <ESP8266WiFi.h>
#include <ESP8266WebServer.h>
#include <AccelStepper.h>
#include <ElegantOTA.h>
#include <SoftwareSerial.h>
#include <TMCStepper.h>
#include <time.h>
#include <sys/time.h>
#include <coredecls.h>
#include <EEPROM.h>

// ============================================================
//  WiFi
//  Данные вынесены в secrets.h (не коммитить!). Шаблон: secrets.h.example
// ============================================================
#include "secrets.h"

// ============================================================
//  Пины драйверов TMC2209 (STEP/DIR/EN — как у A4988)
// ============================================================
#define RA_STEP_PIN    4
#define RA_DIR_PIN     5
#define RA_ENABLE_PIN  0

#define DEC_STEP_PIN   12
#define DEC_DIR_PIN    14
#define DEC_ENABLE_PIN 13

// Датчик Холла A3144 — концевик Home по DEC (см. HALL_SENSOR_DEC_HOME.md).
// У GPIO16 нет подтяжки к питанию: внешние 10 кОм к 3.3 V. LOW = магнит.
#define DEC_HOME_PIN   16

// ============================================================
//  Механика
// ============================================================
const int   MICROSTEPS     = 16;
const int   STEPS_PER_REV  = 200 * MICROSTEPS;   // 3200 шаг/об

// DEC: шестерни 2×10 = 1:5
const float DEC_GEAR_RATIO  = 5.0f;
const double DEC_STEPS_PER_DEG =
    (STEPS_PER_REV * DEC_GEAR_RATIO) / 360.0;   // 44.444 (не округлять — 1% ошибки)

// RA: ремень GT2 16→80 (×5) + червяк EQ2 (×144) = 1:720
const float RA_BELT_RATIO  = 80.0f / 16.0f;
const float RA_WORM_RATIO  = 144.0f;
const float RA_TOTAL_RATIO = RA_BELT_RATIO * RA_WORM_RATIO; // 720
const long  RA_STEPS_PER_DEG =
    (long)((STEPS_PER_REV * RA_TOTAL_RATIO) / 360.0f);   // 6400

// Сидерическая скорость
const float SIDEREAL_RATE     = 360.0f / 86164.0f;       // °/сек
const float RA_SIDEREAL_SPEED = SIDEREAL_RATE * RA_STEPS_PER_DEG;

// Инверсия направления (поменяйте знак если крутит не туда)
const int   RA_DIR  =  1;
const int   DEC_DIR =  1;

// Механический часовой угол оси RA в домашнем положении (противовес вниз,
// труба на полюс), градусы. −90: из дома DEC− опускает трубу на восток,
// +90 — на запад. На монтировке проверено: восток.
const double HOME_HA_DEG  = -90.0;
// GoTo ниже этой высоты над горизонтом не выполняется, градусы
const double GOTO_MIN_ALT = 0.0;
// Наземный ориентир для привязки без звёзд: антенна на 10 этаже соседнего
// дома (102.4 м, азимут 146.7°, высота 4.7° с 7 этажа, широта 50.46°).
// Неподвижен, поэтому задан часовым углом, а не RA: время не нужно.
const double LANDMARK_HA_DEG  = -38.23;   // к востоку от меридиана = 21h27m05s
const double LANDMARK_DEC_DEG = -27.85;   // −27°51′

// ============================================================
//  Объекты
// ============================================================
AccelStepper stepperRA (AccelStepper::DRIVER, RA_STEP_PIN,  RA_DIR_PIN);
AccelStepper stepperDEC(AccelStepper::DRIVER, DEC_STEP_PIN, DEC_DIR_PIN);
ESP8266WebServer server(80);

// ============================================================
//  TMC2209 UART — однопроводная шина на D4 (GPIO2) через 1 кОм
//  к общему узлу PDN_UART. Адреса: RA = 0, DEC = 1 (MS1/MS2).
// ============================================================
#define TMC_UART_PIN   2
const long  TMC_BAUD       = 57600;   // ≤74880 — асинхронный RX-ISR SoftwareSerial
const float TMC_RSENSE     = 0.11f;
const int   RA_CURRENT_MA  = 1190;    // 70% от 1.7 A (JK42HS40-1704)
const int   DEC_CURRENT_MA = 840;     // 70% от 1.2 A (JK42HS60-1206)

// SoftwareSerial в onewire-режиме сам не переключает пин на передачу —
// обёртка включает TX на время записи. Пока TX включён, RX выключен,
// поэтому собственного эха в приёмном буфере нет.
class OneWireUart : public Stream {
public:
    explicit OneWireUart(SoftwareSerial& s) : ss(s) {}
    size_t write(uint8_t b) override {
        ss.enableTx(true);
        size_t n = ss.write(b);
        ss.enableTx(false);
        return n;
    }
    int available() override { return ss.available(); }
    int read()      override { return ss.read(); }
    int peek()      override { return ss.peek(); }
    void flush()    override {}
private:
    SoftwareSerial& ss;
};

SoftwareSerial tmcSerial;
OneWireUart    tmcBus(tmcSerial);
TMC2209Stepper drvRA (&tmcBus, TMC_RSENSE, 0);
TMC2209Stepper drvDEC(&tmcBus, TMC_RSENSE, 1);
bool raDrvOk  = false;
bool decDrvOk = false;
unsigned long lastTmcCheck = 0;

// ============================================================
//  Состояние монтировки
// ============================================================
bool   trackingEnabled = false;
float  raSpeedMult     = 1.0f;    // множитель сидерической скорости
float  raManualSpeed   = 0.0f;    // °/сек, ручное RA
float  decManualSpeed  = 0.0f;    // °/сек, ручное DEC
bool   isParked        = false;
bool   parkPending     = false;   // Park: оси идут в положение парковки
bool   isSlewing       = false;
bool   raSlew          = false;   // ось RA идёт по moveTo()/run()
bool   decSlew         = false;   // ось DEC идёт по moveTo()/run()
bool   gotoPending     = false;   // GoTo ждёт доводки по RA
int    gotoPass        = 0;

// Источник времени: 0 — не задано, 1 — вручную (браузер/LX200), 2 — NTP
uint8_t timeSource     = 0;
double  lxUtcOffsetH   = 0.0;     // LX200 :SG — сколько часов прибавить к местному, чтобы получить UTC
long    lxLocalSecs    = -1;      // LX200 :SL — местное время, с от полуночи

// Координаты на эпоху даты (RA = LST − HA), градусы
double currentRA_deg  = 0.0;     // 0..360
double currentDEC_deg = 0.0;     // -90..+90
double targetRA_deg   = 0.0;
double targetDEC_deg  = 0.0;

// Геопозиция обсерватории
double obsLongitude_deg = 30.5;  // ← ваша долгота (East +)
double obsLatitude_deg  = 50.5;  // ← ваша широта  (North +)
double obsAltitude_m    = 30.0;  // ← высота над уровнем моря, м

// ============================================================
//  Авто-отключение моторов
// ============================================================
const unsigned long MOTOR_OFF_DELAY = 1000;  // мс
unsigned long raStopTime  = 0;
unsigned long decStopTime = 0;
bool raMoving  = false;
bool decMoving = false;

// Удержание оси DEC мотором после остановки.
// true  = мотор DEC остаётся включённым (рекомендуется если ось ослаблена).
// false = мотор DEC отключается через MOTOR_OFF_DELAY мс (тихий режим).
bool decHoldEnabled = true;

// Датчик Холла DEC: состояние после антидребезга, число переключений
// и механический DEC в момент последнего входа в зону и выхода из неё
const unsigned long HALL_DEBOUNCE_MS = 5;
bool hallActive     = false;   // true = магнит у датчика (на пине LOW)
bool hallRaw        = false;
unsigned long hallRawTime = 0;
unsigned long hallEdges   = 0;
double hallEnterDEC = NAN, hallExitDEC = NAN;

// Привязка DEC по датчику: быстро до магнита, назад из зоны, медленно через
// зону насквозь; середина зоны — метка с известным механическим DEC
// (hallMarkDEC, магнит стоит в зоне парковки). Направление — к метке по
// текущему счётчику (подсказка), окно поиска ограничено.
enum HomeState { HOME_IDLE, HOME_FAST, HOME_BACK, HOME_SLOW, HOME_CENTER };
HomeState homeState = HOME_IDLE;
const float  HOME_FAST_SPEED = 6.0f;    // °/с, до магнита и назад
const float  HOME_SLOW_SPEED = 1.0f;    // °/с, замер краёв зоны
const double HOME_OVERSHOOT  = 30.0;    // ° за ожидаемой меткой, дальше не ищем
const double HOME_BACKOFF    = 3.0;     // ° за краем зоны при отъезде
const double HOME_MAX_ZONE   = 30.0;    // ° — зона шире значит неисправность
int    homeDir   = 1;                   // механическое направление подхода
double homeLimit = 0;                   // механический DEC, дальше которого не едем
double homeA = NAN, homeB = NAN;        // края зоны (по старому счётчику)
double homeShift = NAN;                 // на сколько поправили счётчик, °
bool   homeCalibrate = false;           // только измерить метку, счётчик не трогать
String homeMsg = "";                    // результат последнего поиска

// Механический DEC середины зоны магнита. Измерен 2026-10-31 после Sync на
// антенну; точное значение — калибровкой (/home-search?calibrate=1), во флеш.
const double HALL_MARK_DEFAULT = 71.10;
double hallMarkDEC = HALL_MARK_DEFAULT;

void homeFail(const char* why) {
    homeState = HOME_IDLE;
    homeMsg   = String("Метка не найдена: ") + why;
    Serial.println(homeMsg);
}

// ============================================================
//  Настройки моторов
// ============================================================
float raMaxSpeed  = 6000.0f;
float raAccel     = 1000.0f;
float decMaxSpeed =  500.0f;
float decAccel    =  100.0f;

unsigned long lastTrackUpdate = 0;

// ============================================================
//  LX200 TCP сервер (порт 4030)
// ============================================================
WiFiServer lxTcpServer(4030);
WiFiClient lxTcpClient;
bool       lxClientConnected = false;
String     lxTcpBuf          = "";
// Флаг: мы внутри команды (между ':' и '#').
// БЕЗ него ':' внутри аргумента (:Sr22:01:48#, :Sd+45*30:00#)
// сбрасывал буфер и на обработку попадал только хвост ("48", "00").
bool       lxInCommand       = false;

// LX200 переменные
// Скорости :R0#..:R9# в кратных сидерической — как подписаны в INDI LX200 OnStep
const float LX_RATES[10] = {0.25f, 0.5f, 1.f, 2.f, 4.f, 8.f, 20.f, 48.f, 120.f, 240.f};
uint8_t lxRateIndex   = 2;
float lxGuideRate     = SIDEREAL_RATE; // °/сек (1× sidereal по умолчанию)
bool  lxHighPrecision = true;          // true = HH:MM:SS / +DD*MM:SS

// Импульсное гидирование (:MgdNNNN#). RA — добавка к скорости до конца импульса.
// DEC — 81″ на шаг, импульсы короче шага: копим дробные шаги и делаем целые.
const float   GUIDE_RATE_X  = 0.5f;    // скорость поправки, в кратных сидерической
float         raGuideSpeed  = 0.0f;    // °/сек
unsigned long raGuideEnd    = 0;
float         decGuideAcc   = 0.0f;    // накопленные шаги DEC (механика, со знаком)
bool          decGuideMove  = false;   // DEC доходит накопленные шаги

// ============================================================
//  Вспомогательные функции
// ============================================================

double wrap360(double a) { a = fmod(a, 360.0); return a < 0.0 ? a + 360.0 : a; }
double wrap180(double a) { return wrap360(a + 180.0) - 180.0; }

double unixTimeNow() {
    timeval tv;
    gettimeofday(&tv, nullptr);
    return tv.tv_sec + tv.tv_usec * 1e-6;
}

void setClock(double unixSec, uint8_t src) {
    timeval tv;
    tv.tv_sec  = (time_t)unixSec;
    tv.tv_usec = (suseconds_t)((unixSec - floor(unixSec)) * 1e6);
    settimeofday(&tv, nullptr);
    timeSource = src;
    Serial.printf("Time set (%s): %.0f\n", src == 2 ? "NTP" : "manual", unixSec);
}

// Местное звёздное время, градусы (GMST, без нутации — ошибка < 1″ времени)
double lstDeg() {
    double d = (unixTimeNow() - 946728000.0) / 86400.0;   // сутки от J2000.0
    return wrap360(280.46061837 + 360.98564736629 * d + obsLongitude_deg);
}

// Механические углы осей. RA: часовой угол, растёт на запад (по трекингу).
// DEC: 90 — труба на полюс, больше 90 — ось перешла за полюс.
double mechHA()  { return stepperRA .currentPosition() / (double)(RA_STEPS_PER_DEG * RA_DIR); }
double mechDEC() { return stepperDEC.currentPosition() / (DEC_STEPS_PER_DEG * DEC_DIR); }

// За полюсом труба на другой стороне опоры: HA = h + 180°, DEC = 180° − d
bool pierFlipped(double d) { return d > 90.0; }

void mechToEq(double h, double d, double& ra, double& dec) {
    double ha = h;
    dec = d;
    if (pierFlipped(d)) { ha += 180.0; dec = 180.0 - d; }
    ra = wrap360(lstDeg() - ha);
}

// Механическая позиция для (HA, DEC) на нужной стороне опоры;
// h берётся ближайшим к refH (без лишних оборотов оси)
void haDecToMech(double ha, double dec, bool flip, double refH, double& h, double& d) {
    d = dec;
    if (flip) { ha += 180.0; d = 180.0 - dec; }
    h = refH + wrap180(ha - refH);
}

void eqToMech(double ra, double dec, bool flip, double refH, double& h, double& d) {
    haDecToMech(lstDeg() - ra, dec, flip, refH, h, d);
}

// Сторона опоры для GoTo — та, где противовес ниже оси RA (|h − HOME_HA_DEG| ≤ 90°)
void gotoMech(double ha, double dec, double& h, double& d) {
    double hf, df;
    haDecToMech(ha, dec, false, HOME_HA_DEG, h,  d);
    haDecToMech(ha, dec, true,  HOME_HA_DEG, hf, df);
    if (fabs(hf - HOME_HA_DEG) < fabs(h - HOME_HA_DEG)) { h = hf; d = df; }
}

void altAz(double ra, double dec, double& alt, double& az) {
    double ha = (lstDeg() - ra) * DEG_TO_RAD;
    double de = dec * DEG_TO_RAD, la = obsLatitude_deg * DEG_TO_RAD;
    alt = asin(sin(de)*sin(la) + cos(de)*cos(la)*cos(ha)) * RAD_TO_DEG;
    az  = wrap360(atan2(-cos(de)*sin(ha),
                        sin(de)*cos(la) - cos(de)*sin(la)*cos(ha)) * RAD_TO_DEG);
}

void updateCurrentCoords() {
    mechToEq(mechHA(), mechDEC(), currentRA_deg, currentDEC_deg);
}

void enableRA (bool on) { digitalWrite(RA_ENABLE_PIN,  on ? LOW : HIGH); }
void enableDEC(bool on) { digitalWrite(DEC_ENABLE_PIN, on ? LOW : HIGH); }

void startSlewMech(double h, double d) {
    parkPending = false;
    raManualSpeed = decManualSpeed = 0;
    raGuideSpeed = 0; decGuideAcc = 0; decGuideMove = false;
    enableRA(true);
    enableDEC(true);
    stepperRA .setSpeed(0);
    stepperDEC.setSpeed(0);
    // moveTo() пересчитывает скорость, только если цель изменилась, а джог
    // (runSpeed) цель не двигает: Park/GoTo в точку прежней цели после джога
    // оставлял ось без скорости, и run() вечно ждал. Сначала цель = здесь.
    stepperRA .moveTo(stepperRA .currentPosition());
    stepperDEC.moveTo(stepperDEC.currentPosition());
    stepperRA .moveTo(lround(h * RA_STEPS_PER_DEG  * RA_DIR));
    stepperDEC.moveTo(lround(d * DEC_STEPS_PER_DEG * DEC_DIR));
    raSlew = decSlew = true;
    raMoving = decMoving = true;
    isSlewing = true;
    isParked  = false;
}

// GoTo по RA/DEC. Сторона опоры — та, где противовес ниже оси RA
// (|h − HOME_HA_DEG| ≤ 90°). false — время не задано или цель ниже GOTO_MIN_ALT.
bool startGoTo(double ra_deg, double dec_deg) {
    if (!timeSource) {
        Serial.println(F("GoTo refused: time not set"));
        return false;
    }
    double alt, az;
    altAz(ra_deg, dec_deg, alt, az);
    if (alt < GOTO_MIN_ALT) {
        Serial.printf("GoTo refused: RA=%.4f° DEC=%.4f° alt=%.1f°\n", ra_deg, dec_deg, alt);
        return false;
    }
    targetRA_deg  = ra_deg;
    targetDEC_deg = dec_deg;
    double h, d;
    gotoMech(lstDeg() - ra_deg, dec_deg, h, d);
    startSlewMech(h, d);
    gotoPending = true;
    gotoPass    = 0;
    Serial.printf("GoTo: RA=%.4f° DEC=%.4f° → HA mech=%.4f° DEC mech=%.4f°\n",
                  ra_deg, dec_deg, h, d);
    return true;
}

// Плавная остановка GoTo (с торможением)
void haltSlew() {
    if (homeState != HOME_IDLE && homeState != HOME_CENTER) homeFail("остановлен");
    gotoPending = false;
    parkPending = false;
    if (raSlew)  stepperRA .stop();
    if (decSlew) stepperDEC.stop();
}

// Мгновенная остановка: сброс скорости и цели
void abortSlew() {
    if (homeState != HOME_IDLE && homeState != HOME_CENTER) homeFail("прерван");
    gotoPending = false;
    parkPending = false;
    raSlew = decSlew = false;
    stepperRA .setCurrentPosition(stepperRA .currentPosition());
    stepperDEC.setCurrentPosition(stepperDEC.currentPosition());
}

// Принять механическое положение осей (h, d) за текущее
void syncMech(double ha, double dec, double h1, double d1) {
    abortSlew();
    stepperRA .setCurrentPosition(lround(h1 * RA_STEPS_PER_DEG  * RA_DIR));
    stepperDEC.setCurrentPosition(lround(d1 * DEC_STEPS_PER_DEG * DEC_DIR));
    Serial.printf("Sync → HA=%.4f° DEC=%.4f° (HA mech=%.4f° DEC mech=%.4f°)\n",
                  ha, dec, h1, d1);
}

// Монтировка смотрит на (HA, DEC). Сторона опоры — ближайшая к текущей.
void syncHaDec(double ha, double dec) {
    double h = mechHA(), d = mechDEC();
    double h1, d1, h2, d2;
    haDecToMech(ha, dec, false, h, h1, d1);
    haDecToMech(ha, dec, true,  h, h2, d2);
    if (fabs(h2 - h) + fabs(d2 - d) < fabs(h1 - h) + fabs(d1 - d)) { h1 = h2; d1 = d2; }
    syncMech(ha, dec, h1, d1);
}

// Sync: монтировка смотрит на (RA, DEC).
// false — время не задано (без LST привязка RA бессмысленна).
bool syncTo(double ra_deg, double dec_deg) {
    if (!timeSource) {
        Serial.println(F("Sync refused: time not set"));
        return false;
    }
    syncHaDec(lstDeg() - ra_deg, dec_deg);
    return true;
}

// Ориентир неподвижен: трекинг выключаем, иначе труба уйдёт с него.
// Труба наведена на антенну, значит уже не в парковке. Сторона опоры — как
// у GoTo (противовес внизу): к ориентиру приходят джогом из неизвестного
// положения, и «ближайшая к счётчику» сторона бывает перевёрнутой.
void syncLandmark() {
    trackingEnabled = false;
    isParked        = false;
    double h, d;
    gotoMech(LANDMARK_HA_DEG, LANDMARK_DEC_DEG, h, d);
    syncMech(LANDMARK_HA_DEG, LANDMARK_DEC_DEG, h, d);
}

void gotoLandmark() {
    trackingEnabled = false;
    gotoPending     = false;
    double h, d;
    gotoMech(LANDMARK_HA_DEG, LANDMARK_DEC_DEG, h, d);
    startSlewMech(h, d);
    Serial.printf("GoTo landmark → HA mech=%.4f° DEC mech=%.4f°\n", h, d);
}

// Домашнее положение: противовес вниз, труба на полюс
void setHomePosition() {
    abortSlew();
    stepperRA .setCurrentPosition(lround(HOME_HA_DEG * RA_STEPS_PER_DEG  * RA_DIR));
    stepperDEC.setCurrentPosition(lround(90.0        * DEC_STEPS_PER_DEG * DEC_DIR));
    Serial.println(F("Home set (pole, counterweight down)"));
}

// Метка датчика во флеше — после записи парковки (ParkData < 32 байт)
struct HallMarkData { uint32_t magic; double dec; };
const uint32_t HALL_MAGIC = 0x314B4D48;   // "HMK1"
const int      HALL_EEPROM_ADDR = 32;

void loadHallMark() {
    HallMarkData m;
    EEPROM.get(HALL_EEPROM_ADDR, m);
    if (m.magic == HALL_MAGIC && !isnan(m.dec)) hallMarkDEC = m.dec;
}

bool saveHallMark(double dec) {
    hallMarkDEC = dec;
    HallMarkData m = { HALL_MAGIC, dec };
    EEPROM.put(HALL_EEPROM_ADDR, m);
    return EEPROM.commit();
}

// Привязка DEC по датчику Холла. dir: +1/−1 — механическое направление,
// 0 — к метке по текущему счётчику (из N-половины ниже метки это DEC+).
// calibrate: счётчик верен (только что Sync) — измерить метку и сохранить.
// Ось RA не трогаем: поправляется только счётчик DEC.
double homeStage = 0;   // механический DEC в начале этапа
double homeBackTo = NAN;

bool startHomeSearch(int dir, bool calibrate) {
    if (isSlewing) { homeMsg = "Монтировка движется — дождитесь остановки"; return false; }
    double d = mechDEC();
    homeDir   = dir ? (dir > 0 ? 1 : -1) : (d <= hallMarkDEC ? 1 : -1);
    homeLimit = homeDir > 0 ? max(d, hallMarkDEC) + HOME_OVERSHOOT
                            : min(d, hallMarkDEC) - HOME_OVERSHOOT;
    decManualSpeed = 0; decGuideAcc = 0; decGuideMove = false;
    isParked = false;
    homeCalibrate = calibrate;
    homeA = homeB = homeShift = homeBackTo = NAN;
    homeStage = d;
    homeState = hallActive ? HOME_BACK : HOME_FAST;
    homeMsg   = calibrate ? "Калибровка метки…" : "Поиск метки…";
    enableDEC(true);
    Serial.printf("Hall search%s: from mech DEC %.3f, mark %.3f, dir %+d, limit %.1f\n",
                  calibrate ? " (calibrate)" : "", d, hallMarkDEC, homeDir, homeLimit);
    return true;
}

// Пройдено ли положение p по ходу s (+1 — по homeDir, −1 — против)
bool homePassed(double p, int s) { return s * homeDir * (mechDEC() - p) >= 0; }

void homeDrive(float speed, int s) {
    stepperDEC.setSpeed(s * homeDir * speed * DEC_STEPS_PER_DEG * DEC_DIR);
    stepperDEC.runSpeed();
}

// Один шаг автомата поиска; вызывается из loop() вместо джога DEC
void homeSearchStep() {
    switch (homeState) {
    case HOME_FAST:
        if (hallActive) { homeState = HOME_BACK; homeStage = mechDEC(); break; }
        if (homePassed(homeLimit, 1)) { homeFail("магнита нет в окне поиска"); break; }
        homeDrive(HOME_FAST_SPEED, 1);
        break;
    case HOME_BACK:
        // Назад из зоны и ещё HOME_BACKOFF, чтобы замер начинался до края
        if (isnan(homeBackTo) && !hallActive) homeBackTo = hallExitDEC - homeDir * HOME_BACKOFF;
        if (!isnan(homeBackTo) && homePassed(homeBackTo, -1)) {
            homeState = HOME_SLOW; homeStage = mechDEC(); break;
        }
        if (fabs(mechDEC() - homeStage) > HOME_MAX_ZONE + HOME_BACKOFF) {
            homeFail("не выходит из зоны магнита"); break;
        }
        homeDrive(HOME_FAST_SPEED, -1);
        break;
    case HOME_SLOW:
        if (isnan(homeA) && hallActive) homeA = hallEnterDEC;
        if (!isnan(homeA) && !hallActive) {
            homeB = hallExitDEC;
            double c  = (homeA + homeB) / 2;
            if (homeCalibrate) {
                // Счётчик верен: середина зоны и есть метка
                homeShift = c - hallMarkDEC;   // насколько сдвинулась метка
                saveHallMark(c);
            } else {
                // Середина зоны по старому счётчику — это hallMarkDEC
                homeShift = hallMarkDEC - c;
                stepperDEC.setCurrentPosition(stepperDEC.currentPosition()
                                              + lround(homeShift * DEC_STEPS_PER_DEG * DEC_DIR));
            }
            stepperDEC.moveTo(lround(hallMarkDEC * DEC_STEPS_PER_DEG * DEC_DIR));
            decSlew   = true;
            homeState = HOME_CENTER;
            Serial.printf("Hall: zone %.3f..%.3f (%.3f°), mark %.3f, shift %+.3f°\n",
                          homeA, homeB, fabs(homeB - homeA), hallMarkDEC, homeShift);
            break;
        }
        if (isnan(homeA) && fabs(mechDEC() - homeStage) > HOME_BACKOFF + 10.0) {
            homeFail("магнит потерян при медленном проходе"); break;
        }
        if (!isnan(homeA) && fabs(mechDEC() - homeA) > HOME_MAX_ZONE) {
            homeFail("зона магнита слишком широкая"); break;
        }
        homeDrive(HOME_SLOW_SPEED, 1);
        break;
    case HOME_CENTER:
        if (!decSlew) {
            homeState = HOME_IDLE;
            char buf[96];
            if (homeCalibrate)
                snprintf(buf, sizeof buf, "Метка сохранена: DEC %.2f° (сдвиг %+.2f°), зона %.2f°",
                         hallMarkDEC, homeShift, fabs(homeB - homeA));
            else
                snprintf(buf, sizeof buf, "Метка найдена: поправка DEC %+.2f°, зона %.2f°",
                         homeShift, fabs(homeB - homeA));
            homeMsg = buf;
            Serial.println(homeMsg);
        }
        break;
    default: break;
    }
}

// Положение парковки — механические шаги осей. Хранится во флеше (EEPROM-
// эмуляция), чтобы после выключения монтировка знала, где стоит.
// Пока не сохранено (Set Park, :hQ#) — дом.
struct ParkData { uint32_t magic; long ra; long dec; };
const uint32_t PARK_MAGIC = 0x314B5250;   // "PRK1"
long parkRA  = lround(HOME_HA_DEG * RA_STEPS_PER_DEG  * RA_DIR);
long parkDEC = lround(90.0        * DEC_STEPS_PER_DEG * DEC_DIR);

bool loadPark() {
    ParkData p;
    EEPROM.get(0, p);
    if (p.magic != PARK_MAGIC) return false;
    parkRA = p.ra; parkDEC = p.dec;
    return true;
}

// Запомнить текущее положение как парковку. Не во время движения осей.
bool savePark() {
    if (isSlewing) return false;
    parkRA  = stepperRA .currentPosition();
    parkDEC = stepperDEC.currentPosition();
    ParkData p = { PARK_MAGIC, parkRA, parkDEC };
    EEPROM.put(0, p);
    bool ok = EEPROM.commit();
    Serial.printf("Park saved: HA=%.4f° DEC=%.4f° (mech) %s\n",
                  parkRA / (double)(RA_STEPS_PER_DEG * RA_DIR),
                  parkDEC / (DEC_STEPS_PER_DEG * DEC_DIR), ok ? "OK" : "FAILED");
    return ok;
}

// Увести оси в положение парковки; isParked ставит loop(), когда оси дойдут
void parkMount() {
    trackingEnabled = false;
    gotoPending     = false;
    startSlewMech(parkRA  / (double)(RA_STEPS_PER_DEG * RA_DIR),
                  parkDEC / (DEC_STEPS_PER_DEG * DEC_DIR));
    parkPending = true;
}

// ============================================================
//  HTML веб-интерфейс
// ============================================================
// Во флеше (PROGMEM): в ОЗУ страница не помещается вместе с копией при отдаче
const char htmlPage[] PROGMEM = R"rawliteral(
<!DOCTYPE html>
<html>
<head>
  <meta charset="UTF-8">
  <meta name="viewport" content="width=device-width, initial-scale=1.0">
  <title>EQ2 Mount</title>
  <style>
    *{margin:0;padding:0;box-sizing:border-box}
    body{font-family:'Segoe UI',sans-serif;
         background:linear-gradient(135deg,#1a1a2e 0%,#16213e 50%,#0f3460 100%);
         min-height:100vh;padding:12px;color:#e0e0e0}
    .container{max-width:820px;margin:0 auto}

    /* ── Статус-строка ── */
    .statusbar{background:rgba(0,0,0,0.45);border:1px solid rgba(255,255,255,0.1);
               border-radius:10px;padding:10px 14px;margin-bottom:10px;
               font-size:13px;line-height:1.7;text-align:center}
    .statusbar .coords{font-size:1.2em;font-weight:700;color:#e2b96f;
                       letter-spacing:.03em;margin-bottom:4px}

    /* ── Секции ── */
    .card{background:rgba(255,255,255,0.04);border:1px solid rgba(255,255,255,0.08);
          border-radius:10px;margin-bottom:8px;overflow:hidden}

    /* Заголовок секции — кнопка раскрытия */
    .card-hdr{display:flex;align-items:center;justify-content:space-between;
              padding:10px 14px;cursor:pointer;user-select:none;
              border-bottom:1px solid transparent;transition:background .2s}
    .card-hdr:hover{background:rgba(255,255,255,0.05)}
    .card-hdr h2{font-size:1em;font-weight:600;color:#a0c4ff;margin:0}
    .card-hdr .arr{font-size:.75em;color:#666;transition:transform .25s}
    .card-hdr.open{border-bottom-color:rgba(255,255,255,0.08)}
    .card-hdr.open .arr{transform:rotate(180deg)}

    /* Тело секции */
    .card-body{padding:12px 14px;display:none}
    .card-body.open{display:block}

    /* Секции всегда открытые (без заголовка-кнопки) */
    .card-always .card-body{display:block;padding:12px 14px}

    /* ── Сетка ── */
    .g2{display:grid;grid-template-columns:1fr 1fr;gap:8px}
    .help{width:100%;border-collapse:collapse;font-size:13px}
    .help td{padding:5px 6px;border-top:1px solid rgba(255,255,255,0.08);vertical-align:top}
    .help td:first-child{white-space:nowrap;color:#e2b96f}
    .g3{display:grid;grid-template-columns:1fr 1fr 1fr;gap:8px}
    .mview svg{width:100%;height:auto;display:block;background:rgba(0,0,0,0.25);border-radius:8px}
    .mview .cap{font-size:12px;color:#888;text-align:center;margin-top:4px}
    .mvals{font-size:13px;text-align:center;margin-top:8px;line-height:1.6}
    .mvals b{color:#e2b96f;font-weight:600}
    @media(max-width:500px){.g2,.g3{grid-template-columns:1fr}}

    /* ── Координаты ── */
    .coord-box{background:rgba(0,0,0,0.3);border-radius:7px;
               padding:8px;text-align:center}
    .coord-val{font-size:1.25em;color:#e2b96f;font-weight:700}
    .coord-lbl{font-size:.75em;color:#777;margin-top:2px}

    /* ── Ввод ── */
    label{display:block;margin-bottom:4px;font-size:.85em;color:#bbb}
    input[type=range]{width:100%;height:5px;border-radius:3px;
                      background:rgba(255,255,255,0.15);outline:none;margin-top:2px}
    input[type=number],input[type=text]{width:100%;padding:7px 10px;
                       border:1px solid rgba(255,255,255,0.15);border-radius:7px;
                       background:rgba(255,255,255,0.08);color:#fff;font-size:14px}

    /* ── Кнопки ── */
    button{width:100%;padding:10px;margin:4px 0;border:none;
           border-radius:8px;font-size:14px;font-weight:600;
           cursor:pointer;transition:all .2s}
    .btn-track{background:linear-gradient(135deg,#10b981,#059669);color:#fff}
    .btn-stop {background:linear-gradient(135deg,#ef4444,#dc2626);color:#fff}
    .btn-nav  {background:rgba(96,165,250,0.2);color:#93c5fd;
               border:1px solid rgba(96,165,250,0.3)}
    .btn-goto {background:linear-gradient(135deg,#f59e0b,#d97706);color:#fff}
    .btn-muted{background:rgba(255,255,255,0.08);color:#ccc}
    .btn-warn {background:rgba(239,68,68,0.18);color:#fca5a5;
               border:1px solid rgba(239,68,68,0.3)}
    .btn-estop{background:linear-gradient(135deg,#ef4444,#dc2626);color:#fff;
               font-size:16px;padding:13px}
    button:hover{filter:brightness(1.18);box-shadow:0 3px 10px rgba(0,0,0,0.3)}
    button:active{filter:brightness(.9)}

    /* ── D-pad ── */
    .dpad{display:grid;grid-template-columns:repeat(5,52px);
          grid-template-rows:repeat(5,44px);gap:6px;margin:0 auto;width:284px}
    .dpad button{padding:0;font-size:18px;border-radius:7px;margin:0;width:auto;height:auto;line-height:1.1}
    .dpad button small{display:block;font-size:10px;font-weight:600;opacity:.85}
    .dpad .fine{font-size:13px;opacity:.8}
    .cell-N {grid-column:3;grid-row:1}  .cell-n{grid-column:3;grid-row:2}
    .cell-W {grid-column:1;grid-row:3}  .cell-w{grid-column:2;grid-row:3}
    .cell-C {grid-column:3;grid-row:3}
    .cell-e {grid-column:4;grid-row:3}  .cell-E{grid-column:5;grid-row:3}
    .cell-s {grid-column:3;grid-row:4}  .cell-D{grid-column:3;grid-row:5}
    .cell-ne{grid-column:2;grid-row:2}  .cell-nw{grid-column:4;grid-row:2}
    .cell-se{grid-column:2;grid-row:4}  .cell-sw{grid-column:4;grid-row:4}

    /* ── Info box ── */
    .ibox{background:rgba(0,0,0,0.22);border-radius:7px;
          padding:9px 12px;margin-top:8px;font-size:12px;
          border:1px solid rgba(255,255,255,0.06);line-height:1.65;color:#aaa}
    code{background:rgba(255,255,255,0.09);padding:1px 5px;
         border-radius:3px;font-family:monospace;font-size:11px}
    .dot{display:inline-block;width:8px;height:8px;border-radius:50%;margin-right:5px}
    .dot-g{background:#10b981} .dot-r{background:#ef4444}
    .badge{display:inline-block;padding:2px 8px;margin:2px;
           border-radius:4px;background:rgba(255,255,255,0.09);font-size:11px}

    /* ── Toggle switch ── */
    .tog{position:relative;display:inline-block;width:52px;height:28px;flex-shrink:0}
    .tog input{opacity:0;width:0;height:0}
    .tog-sl{position:absolute;cursor:pointer;inset:0;
            background:rgba(239,68,68,.55);border-radius:28px;transition:.3s}
    .tog-sl:before{content:"";position:absolute;width:20px;height:20px;
                   left:4px;bottom:4px;background:#fff;border-radius:50%;transition:.3s}
    .tog input:checked+.tog-sl{background:#10b981}
    .tog input:checked+.tog-sl:before{transform:translateX(24px)}

    /* ── Заголовок страницы ── */
    .page-title{text-align:center;font-size:1.5em;color:#e2b96f;
                text-shadow:0 0 18px rgba(226,185,111,.35);
                padding:10px 0 8px;font-weight:700}
  </style>
</head>
<body>
<div class="container">

  <div class="page-title">🔭 EQ2 Mount</div>

  <!-- ═══ Статус (всегда виден) ════════════════════════════════════════ -->
  <div class="statusbar">
    <div class="coords">RA <span id="raHms">—</span> (<span id="raVal">—</span>°)&nbsp;&nbsp;DEC <span id="decVal">—</span>°</div>
    <span id="statusBox">Loading…</span>
  </div>

  <!-- ═══ Трекинг + экстренная остановка (всегда видны) ═══════════════ -->
  <div class="card card-always">
    <div class="card-body">
      <div class="g2" style="align-items:center;gap:8px">
        <button id="trackBtn" class="btn-track" onclick="toggleTracking()" title="Включить/выключить ведение: ось RA вращается со звёздной скоростью, звезда стоит в поле">▶ Start Tracking</button>
        <button class="btn-estop" onclick="emergencyStop()" title="Аварийная остановка: мгновенно, без торможения; трекинг выключается, мотор RA обесточивается">⛔ STOP</button>
      </div>
      <div style="margin-top:10px">
        <label>Tracking speed: <span id="spdVal">1.00×</span> sidereal</label>
        <input type="range" min="0" max="2" step="0.05" value="1" oninput="setTrackSpeed(this.value)">
      </div>
    </div>
  </div>

  <!-- ═══ Ручное управление (всегда видно) ════════════════════════════ -->
  <div class="card card-always">
    <div class="card-body">
      <!-- Внешние стрелки — скорость с ползунка, внутренние — медленно (JOG_FINE) -->
      <div class="dpad">
        <button class="btn-nav cell-N" title="На север (DEC+) со скоростью с ползунка, пока кнопка нажата"
          onmousedown="jog('dec',1)" onmouseup="jogStop('dec')" onmouseleave="if(event.buttons)jogStop('dec')"
          ontouchstart="jog('dec',1)" ontouchend="jogStop('dec')">▲<small>N · DEC+</small></button>
        <button class="btn-nav fine cell-n" title="Медленно на север (0.1°/с) — для центрирования"
          onmousedown="jogFine('dec',1)" onmouseup="jogStop('dec')" onmouseleave="if(event.buttons)jogStop('dec')"
          ontouchstart="jogFine('dec',1)" ontouchend="jogStop('dec')">▴<small>slow</small></button>
        <button class="btn-nav cell-W" title="На восток (RA+) со скоростью с ползунка, пока кнопка нажата"
          onmousedown="jog('ra',-1)" onmouseup="jogStop('ra')" onmouseleave="if(event.buttons)jogStop('ra')"
          ontouchstart="jog('ra',-1)" ontouchend="jogStop('ra')">◄<small>E · RA+</small></button>
        <button class="btn-nav fine cell-w" title="Медленно на восток (0.1°/с) — для центрирования"
          onmousedown="jogFine('ra',-1)" onmouseup="jogStop('ra')" onmouseleave="if(event.buttons)jogStop('ra')"
          ontouchstart="jogFine('ra',-1)" ontouchend="jogStop('ra')">◂<small>slow</small></button>
        <button class="btn-stop cell-C" onclick="stopAll()" title="Остановить всё с торможением: GoTo, джог и трекинг">■</button>
        <button class="btn-nav fine cell-ne" title="Медленно на северо-восток: обе оси сразу, под 45° на небе"
          onmousedown="jogDiag(-1,1)" onmouseup="jogStopBoth()" onmouseleave="if(event.buttons)jogStopBoth()"
          ontouchstart="jogDiag(-1,1)" ontouchend="jogStopBoth()">◤<small>N·E</small></button>
        <button class="btn-nav fine cell-nw" title="Медленно на северо-запад: обе оси сразу, под 45° на небе"
          onmousedown="jogDiag(1,1)" onmouseup="jogStopBoth()" onmouseleave="if(event.buttons)jogStopBoth()"
          ontouchstart="jogDiag(1,1)" ontouchend="jogStopBoth()">◥<small>N·W</small></button>
        <button class="btn-nav fine cell-se" title="Медленно на юго-восток: обе оси сразу, под 45° на небе"
          onmousedown="jogDiag(-1,-1)" onmouseup="jogStopBoth()" onmouseleave="if(event.buttons)jogStopBoth()"
          ontouchstart="jogDiag(-1,-1)" ontouchend="jogStopBoth()">◣<small>S·E</small></button>
        <button class="btn-nav fine cell-sw" title="Медленно на юго-запад: обе оси сразу, под 45° на небе"
          onmousedown="jogDiag(1,-1)" onmouseup="jogStopBoth()" onmouseleave="if(event.buttons)jogStopBoth()"
          ontouchstart="jogDiag(1,-1)" ontouchend="jogStopBoth()">◢<small>S·W</small></button>
        <button class="btn-nav fine cell-e" title="Медленно на запад (0.1°/с) — для центрирования"
          onmousedown="jogFine('ra',1)" onmouseup="jogStop('ra')" onmouseleave="if(event.buttons)jogStop('ra')"
          ontouchstart="jogFine('ra',1)" ontouchend="jogStop('ra')">▸<small>slow</small></button>
        <button class="btn-nav cell-E" title="На запад (RA−) со скоростью с ползунка, пока кнопка нажата"
          onmousedown="jog('ra',1)" onmouseup="jogStop('ra')" onmouseleave="if(event.buttons)jogStop('ra')"
          ontouchstart="jog('ra',1)" ontouchend="jogStop('ra')">►<small>W · RA−</small></button>
        <button class="btn-nav fine cell-s" title="Медленно на юг (0.1°/с) — для центрирования"
          onmousedown="jogFine('dec',-1)" onmouseup="jogStop('dec')" onmouseleave="if(event.buttons)jogStop('dec')"
          ontouchstart="jogFine('dec',-1)" ontouchend="jogStop('dec')">▾<small>slow</small></button>
        <button class="btn-nav cell-D" title="На юг (DEC−) со скоростью с ползунка, пока кнопка нажата"
          onmousedown="jog('dec',-1)" onmouseup="jogStop('dec')" onmouseleave="if(event.buttons)jogStop('dec')"
          ontouchstart="jog('dec',-1)" ontouchend="jogStop('dec')">▼<small>S · DEC−</small></button>
      </div>
      <div style="margin-top:10px">
        <label>Jog speed: <span id="jogVal">14</span> °/s</label>
        <input type="range" id="jogSpeed" min="2" max="60" step="2" value="14"
               oninput="document.getElementById('jogVal').innerText=this.value">
      </div>
    </div>
  </div>

  <!-- ═══ Схема монтировки (раскрываемая, открыта) ═════════════════════ -->
  <div class="card">
    <div class="card-hdr open" onclick="tog(this)">
      <h2>📐 Положение монтировки</h2><span class="arr">▼</span>
    </div>
    <div class="card-body open">
      <div class="g2">
        <div class="mview"><svg id="mSide" viewBox="-150 -125 300 250"></svg><div class="cap">Сбоку (вид с запада)</div></div>
        <div class="mview"><svg id="mTop"  viewBox="-150 -125 300 250"></svg><div class="cap">Сверху (север вверху)</div></div>
      </div>
      <div class="mvals" id="mVals">—</div>
    </div>
  </div>

  <!-- ═══ GoTo (раскрываемая) ════════════════════════════════════════ -->
  <div class="card">
    <div class="card-hdr" onclick="tog(this)">
      <h2>🎯 GoTo / Sync</h2><span class="arr">▼</span>
    </div>
    <div class="card-body">
      <div class="g2">
        <div>
          <label>RA (° или часы — 02:31:49, 2h31m49s):</label>
          <input type="text" id="gotoRA" value="0" oninput="raHint()">
          <div id="raHint" style="font-size:11px;color:#888;margin-top:2px">= 0.0000°</div>
        </div>
        <div>
          <label>DEC (° или ° ′ ″ — +89 15 51, 89°15′51″):</label>
          <input type="text" id="gotoDEC" value="0" oninput="decHint()">
          <div id="decHint" style="font-size:11px;color:#888;margin-top:2px">= 0.0000°</div>
        </div>
      </div>
      <button class="btn-goto" onclick="doGoTo()" title="Навести трубу на RA/DEC из полей; сторона опоры выбирается так, чтобы противовес был внизу" style="margin-top:8px">🚀 Go To</button>
      <div class="g3">
        <button class="btn-muted" onclick="setPark()" title="Запомнить текущее положение трубы как парковку (во флеш, сохраняется после выключения); Park возвращает сюда">🅿 Set Park</button>
        <button class="btn-muted" onclick="polarSet()" title="Монтировка в доме (противовес вниз, труба на полюс): принять это положение за текущее и подставить в поля координаты полюса">✦ Polar Set</button>
        <button class="btn-muted" onclick="doSync()" title="Труба смотрит на объект с RA/DEC из полей: привязать координаты к нему (центрировать звезду, потом Sync)">⟳ Sync</button>
      </div>
      <div class="g2" style="margin-top:8px">
        <button class="btn-muted" onclick="landmark('sync')" title="Труба наведена на антенну (10 этаж, азимут 146.7°, высота 4.7°): привязать к ней координаты. Время не нужно, трекинг выключается">📡 Sync на антенну</button>
        <button class="btn-muted" onclick="landmark('goto')" title="Навести трубу на антенну — проверить, не сбилась ли привязка. Трекинг выключается">📡 GoTo на антенну</button>
      </div>
      <div class="g2" style="margin-top:8px">
        <button class="btn-muted" onclick="homeSearch(0)" title="Привязать DEC по датчику Холла (магнит в зоне парковки): ось DEC едет к метке, находит края зоны и ставит в её середину сохранённый DEC метки. RA не меняется. Stop прерывает">🧲 Привязка по датчику</button>
        <button class="btn-muted" onclick="homeSearch(1)" title="Координаты только что точно привязаны (Sync на антенну или звезду): найти середину зоны магнита и сохранить её DEC как метку (во флеш). Счётчик не меняется">🧲 Калибровать метку</button>
      </div>
    </div>
  </div>

  <!-- ═══ Park / DEC hold (раскрываемая) ════════════════════════════ -->
  <div class="card">
    <div class="card-hdr" onclick="tog(this)">
      <h2>🅿 Park &amp; DEC Hold</h2><span class="arr">▼</span>
    </div>
    <div class="card-body">
      <div class="g2">
        <button class="btn-warn" onclick="doPark()" title="Выключить трекинг, увести трубу в положение парковки (Set Park) и пометить монтировку запаркованной">Park</button>
        <button class="btn-muted" onclick="doUnpark()" title="Снять отметку «запаркована» — разрешить GoTo из планетариев">Unpark</button>
      </div>
      <div style="display:flex;align-items:center;gap:12px;margin-top:12px;flex-wrap:wrap">
        <label class="tog">
          <input type="checkbox" id="decHoldChk" onchange="setDecHold(this.checked)" title="Держать мотор DEC под током после остановки, чтобы ось не проседала" checked>
          <span class="tog-sl"></span>
        </label>
        <span id="decHoldLabel" style="font-size:.95em;font-weight:600;color:#10b981">
          DEC Hold ON
        </span>
      </div>
      <div class="ibox">
        DEC Hold: мотор удерживает ось после остановки.<br>
        ⚠ Мотор и драйвер DEC постоянно под током (в покое TMC2209 снижает ток вдвое) — нужен радиатор на драйвере.
      </div>
    </div>
  </div>

  <!-- ═══ Настройки моторов (раскрываемая) ══════════════════════════ -->
  <div class="card">
    <div class="card-hdr" onclick="tog(this)">
      <h2>⚙️ Motor Settings</h2><span class="arr">▼</span>
    </div>
    <div class="card-body">
      <div class="g2">
        <div>
          <label>RA max speed (steps/s):</label>
          <input type="number" id="raSpd" value="6000" min="50" max="6000" step="50">
        </div>
        <div>
          <label>DEC max speed (steps/s):</label>
          <input type="number" id="decSpd" value="500" min="50" max="4000" step="50">
        </div>
        <div>
          <label>RA acceleration (steps/s²):</label>
          <input type="number" id="raAcc" value="1000" min="50" max="4000" step="50">
        </div>
        <div>
          <label>DEC acceleration (steps/s²):</label>
          <input type="number" id="decAcc" value="100" min="50" max="1000" step="50">
        </div>
      </div>
      <div class="g2" style="margin-top:8px">
        <button class="btn-muted" onclick="applyMotor('ra')" title="Применить макс. скорость и ускорение RA (до перезагрузки)">Apply RA</button>
        <button class="btn-muted" onclick="applyMotor('dec')" title="Применить макс. скорость и ускорение DEC (до перезагрузки)">Apply DEC</button>
      </div>
    </div>
  </div>

  <!-- ═══ Протоколы (раскрываемая) ══════════════════════════════════ -->
  <div class="card">
    <div class="card-hdr" onclick="tog(this)">
      <h2>🌐 Protocols &amp; Connections</h2><span class="arr">▼</span>
    </div>
    <div class="card-body">
      <span class="badge">✓ RTS2 HTTP/JSON</span>
      <span class="badge">✓ LX200/OnStep TCP:4030</span>
      <div class="ibox">
        <p><span class="dot" id="rts2dot"></span>RTS2: <code id="rts2url">http://…/</code></p>
        <p style="margin-top:5px">LX200: <code id="lx200addr">…:4030</code></p>
        <p style="margin-top:5px">
          <b>Stellarium:</b> Type=RTS2, URL above, Refresh=500ms<br>
          <b>KStars/PHD2/CdC:</b> Type=LX200/OnStep, port 4030
        </p>
      </div>
    </div>
  </div>

  <!-- ═══ Справка по кнопкам (раскрываемая) ═══════════════════════ -->
  <div class="card">
    <div class="card-hdr" onclick="tog(this)">
      <h2>❓ Справка по кнопкам</h2><span class="arr">▼</span>
    </div>
    <div class="card-body">
      <table class="help">
        <tr><td><b>▶ Start Tracking</b></td><td>Включить/выключить ведение: ось RA вращается со звёздной скоростью, звезда стоит в поле</td></tr>
        <tr><td><b>⛔ STOP</b></td><td>Аварийная остановка: мгновенно, без торможения; трекинг выключается, мотор RA обесточивается</td></tr>
        <tr><td><b>■</b></td><td>Остановить всё с торможением: GoTo, джог и трекинг</td></tr>
        <tr><td><b>▲ ▼ ◄ ►</b></td><td>Движение по N/S/E/W со скоростью с ползунка, пока кнопка нажата</td></tr>
        <tr><td><b>▴ ▾ ◂ ▸ (slow)</b></td><td>Медленное движение 0.1°/с — для центрирования звезды</td></tr>
        <tr><td><b>◤ ◥ ◣ ◢</b></td><td>Медленно по диагонали, обе оси сразу: RA 0.1°/с, DEC медленнее в cos(DEC) раз — на небе выходит 45°</td></tr>
        <tr><td><b>🚀 Go To</b></td><td>Навести трубу на RA/DEC из полей; сторона опоры выбирается так, чтобы противовес был внизу</td></tr>
        <tr><td><b>🅿 Set Park</b></td><td>Запомнить текущее положение трубы как парковку — во флеш, сохраняется после выключения. После включения монтировка считает, что стоит в парковке</td></tr>
        <tr><td><b>✦ Polar Set</b></td><td>Монтировка в доме (противовес вниз, труба на полюс): принять это положение за текущее и подставить в поля координаты полюса</td></tr>
        <tr><td><b>⟳ Sync</b></td><td>Труба смотрит на объект с RA/DEC из полей: привязать координаты к нему (центрировать звезду, потом Sync)</td></tr>
        <tr><td><b>📡 Sync на антенну</b></td><td>Труба наведена на антенну на 10 этаже (азимут 146.7°, высота 4.7°): привязать к ней координаты — днём, без звёзд и без времени. Трекинг выключается</td></tr>
        <tr><td><b>📡 GoTo на антенну</b></td><td>Навести трубу на антенну, чтобы проверить привязку. Трекинг выключается</td></tr>
        <tr><td><b>Park</b></td><td>Выключить трекинг, увести трубу в положение парковки (Set Park; пока не задано — дом) и, когда дойдёт, пометить запаркованной</td></tr>
        <tr><td><b>Unpark</b></td><td>Снять отметку «запаркована» — разрешить GoTo из планетариев</td></tr>
        <tr><td><b>DEC Hold</b></td><td>Держать мотор DEC под током после остановки, чтобы ось не проседала</td></tr>
        <tr><td><b>Apply RA / DEC</b></td><td>Применить макс. скорость и ускорение оси (до перезагрузки)</td></tr>
        <tr><td><b>Open Update Page</b></td><td>Открыть страницу загрузки новой прошивки по WiFi</td></tr>
      </table>
      <p style="font-size:11px;color:#888;margin-top:6px">На компьютере то же пояснение всплывает при наведении на кнопку.</p>
    </div>
  </div>

  <!-- ═══ OTA Update (раскрываемая) ════════════════════════════════ -->
  <div class="card">
    <div class="card-hdr" onclick="tog(this)">
      <h2>🔄 Firmware Update (OTA)</h2><span class="arr">▼</span>
    </div>
    <div class="card-body">
      <div class="ibox" style="margin-top:0;margin-bottom:8px">
        Version: <b>6.0</b> &nbsp;|&nbsp; <span id="fwDot" class="dot dot-r"></span><span id="fwState">No connection</span>
        <br>Build: <b id="fwBuild">—</b> &nbsp;|&nbsp; Uptime: <span id="fwUp">—</span>
        <br>WiFi: <span id="fwRssi">—</span> &nbsp;|&nbsp; Free RAM: <span id="fwHeap">—</span>
      </div>
      <button class="btn-muted" onclick="window.open('/update','_blank')" title="Открыть страницу загрузки новой прошивки по WiFi">Open Update Page</button>
      <p style="font-size:11px;color:#666;margin-top:6px">⚠ Do not disconnect power during update!</p>
    </div>
  </div>

</div><!-- /container -->

<script>
var trackOn=false, timeSent=false, curDec=0;
function fmt(v,d){return Number(v).toFixed(d||4);}
function hms(deg){var s=Math.round(((deg%360+360)%360)/15*3600)%86400;
  return [s/3600|0,(s/60|0)%60,s%60].map(x=>('0'+x).slice(-2)).join(':');}

/* ── Раскрытие секций ── */
function tog(hdr){
  hdr.classList.toggle('open');
  hdr.nextElementSibling.classList.toggle('open');
}

/* ── Поллинг статуса ── */
function poll(){
  fetch('/status').then(r=>r.json()).then(d=>{
    document.getElementById('raVal').innerText=fmt(d.ra_deg);
    document.getElementById('raHms').innerText=hms(d.ra_deg).replace(/(\d+):(\d+):(\d+)/,'$1h$2m$3s');
    document.getElementById('decVal').innerText=fmt(d.dec_deg);
    curDec=d.dec_deg;
    document.getElementById('statusBox').innerHTML=
      '<b>Tracking:</b> '+(d.tracking?'<span style="color:#10b981">ON</span>':'OFF')+
      ' &nbsp;|&nbsp; <b>Slewing:</b> '+(d.slewing?'<span style="color:#f59e0b">YES</span>':'NO')+
      ' &nbsp;|&nbsp; <b>Parked:</b> '+(d.parked?'<span style="color:#60a5fa">YES</span>':'NO')+
      '<br><b>LST:</b> '+hms(d.lst)+' &nbsp;|&nbsp; <b>Alt:</b> '+fmt(d.alt,1)+'°'+
      ' &nbsp;|&nbsp; <b>Pier:</b> '+d.pier+
      (d.hall!=null?' &nbsp;|&nbsp; <b>Hall:</b> '+(d.hall?'<span style="color:#10b981">MAGNET</span>':'clear')+
        ' ('+d.hall_edges+')':'')+
      (d.home_msg?'<br><b>Датчик:</b> '+d.home_msg:'')+
      (d.time_ok?'':' &nbsp;|&nbsp; <span style="color:#f59e0b">⚠ время не задано</span>');
    if(!d.time_ok&&!timeSent){timeSent=true;fetch('/set-time?ms='+Date.now());}
    if(d.ip){
      var u='http://'+d.ip+'/';
      document.getElementById('rts2url').innerText=u;
      document.getElementById('lx200addr').innerText=d.ip+':4030';
    }
    document.getElementById('rts2dot').className=
      'dot '+(d.tracking||d.slewing?'dot-g':'dot-r');
    if(typeof d.dec_hold!=='undefined') updateDecHoldUI(d.dec_hold);
    if(d.mech_ha!=null) drawMount(d);
    var bad=[];
    if(d.ra_drv===false) bad.push('RA');
    if(d.dec_drv===false) bad.push('DEC');
    setFwState(!bad.length,bad.length?'Driver fault: '+bad.join(', '):'Ready');
    document.getElementById('fwBuild').innerText=d.fw||'—';
    document.getElementById('fwUp').innerText=d.up!=null?upTime(d.up):'—';
    // Сигнал хуже −75 dBm и свободный блок памяти меньше 4 КБ — уже проблема
    if(d.rssi!=null) document.getElementById('fwRssi').innerHTML=
      '<span style="color:'+(d.rssi<-75?'#ef4444':d.rssi<-67?'#f59e0b':'#10b981')+'">'+d.rssi+' dBm</span>';
    if(d.heap!=null) document.getElementById('fwHeap').innerHTML=
      '<span style="color:'+(d.heap_max<4096?'#ef4444':'inherit')+'">'+(d.heap/1024).toFixed(1)+
      ' KB (max block '+(d.heap_max/1024).toFixed(1)+' KB)</span>';
  }).catch(()=>{
    document.getElementById('statusBox').innerText='Connection error…';
    setFwState(false,'No connection');
  });
}

function setFwState(ok,txt){
  document.getElementById('fwDot').className='dot '+(ok?'dot-g':'dot-r');
  document.getElementById('fwState').innerText=txt;
}
// Аптайм: сразу после прошивки сбрасывается — видно, что монтировка перезагрузилась
function upTime(s){
  var d=Math.floor(s/86400),h=Math.floor(s%86400/3600),m=Math.floor(s%3600/60);
  return (d?d+'d ':'')+(d||h?h+'h ':'')+m+'m '+(s%60)+'s';
}

/* ── Трекинг ── */
function toggleTracking(){
  trackOn=!trackOn;
  fetch('/tracking?enable='+(trackOn?'1':'0')).then(poll);
  var b=document.getElementById('trackBtn');
  b.innerText=trackOn?'⏹ Stop Tracking':'▶ Start Tracking';
  b.className=trackOn?'btn-stop':'btn-track';
}
function setTrackSpeed(v){
  document.getElementById('spdVal').innerText=parseFloat(v).toFixed(2)+'×';
  fetch('/ra-speed?speed='+v);
}

/* ── Джойстик ── */
function jog(axis,dir){
  fetch('/jog?axis='+axis+'&speed='+(dir*document.getElementById('jogSpeed').value));
}
// Медленный джог для центрирования, °/с (≈24× сидерической)
var JOG_FINE=0.1;
function jogFine(axis,dir){fetch('/jog?axis='+axis+'&speed='+(dir*JOG_FINE));}
function jogStop(axis){fetch('/jog?axis='+axis+'&speed=0');}
// Диагональ: на небе RA проходит в cos(DEC) раз меньше, чем те же °/с по DEC
// (у полюса — в десятки раз), поэтому DEC замедляем, чтобы выходило 45°.
// Не меньше 0.1: у самого полюса направления RA нет, DEC иначе почти стоит.
function jogDiag(ra,dec){
  var k=Math.max(Math.cos(curDec*Math.PI/180),0.1);
  fetch('/jog?ra='+(ra*JOG_FINE)+'&dec='+(dec*JOG_FINE*k).toFixed(4));
}
function jogStopBoth(){fetch('/jog?ra=0&dec=0');}
function stopAll(){fetch('/stop-all').then(poll);}

/* ── GoTo ── */
/* RA: число — градусы; с ':' или h/m/s — часы (дробные часы: '2.53h') */
function parseRA(t){
  t=t.trim().replace(',','.');
  if(/^[+]?\d+(\.\d+)?$/.test(t))return parseFloat(t);
  var m=t.match(/^(\d+(?:\.\d+)?)\s*[h:ч]\s*(?:(\d+(?:\.\d+)?)\s*[m:м]?\s*(?:(\d+(?:\.\d+)?)\s*[sс]?)?)?$/i);
  if(!m)return NaN;
  var h=parseFloat(m[1])+(m[2]?parseFloat(m[2])/60:0)+(m[3]?parseFloat(m[3])/3600:0);
  return h<24?h*15:NaN;
}
function raDeg(){
  var v=parseRA(document.getElementById('gotoRA').value);
  if(isNaN(v)||v<0||v>=360){alert('Неверный RA');return null;}
  return v;
}
/* DEC: знак, затем до трёх чисел (градусы, минуты, секунды) через любые
   разделители — пробел, :, °, ′, ″, d m s. Одно число — дробные градусы. */
function parseDEC(t){
  t=t.trim().replace(',','.');
  var sg=/^-/.test(t)?-1:1;
  var p=t.replace(/[^0-9.]+/g,' ').trim().split(' ');
  if(!p[0]||p.length>3||p.some(x=>isNaN(parseFloat(x))))return NaN;
  var d=parseFloat(p[0]),m=p[1]?parseFloat(p[1]):0,s=p[2]?parseFloat(p[2]):0;
  if(m>=60||s>=60)return NaN;
  var v=sg*(d+m/60+s/3600);
  return Math.abs(v)<=90?v:NaN;
}
function dms(v){var s=Math.round(Math.abs(v)*3600);
  return (v<0?'−':'+')+(s/3600|0)+'°'+('0'+((s/60|0)%60)).slice(-2)+'′'+('0'+s%60).slice(-2)+'″';}
function decDeg(){
  var v=parseDEC(document.getElementById('gotoDEC').value);
  if(isNaN(v)){alert('Неверный DEC');return null;}
  return v;
}
function decHint(){
  var v=parseDEC(document.getElementById('gotoDEC').value);
  document.getElementById('decHint').innerText=isNaN(v)?'неверный формат':'= '+fmt(v)+'° = '+dms(v);
}
function raHint(){
  var v=parseRA(document.getElementById('gotoRA').value);
  document.getElementById('raHint').innerText=(isNaN(v)||v>=360)?'неверный формат':
    '= '+fmt(v)+'° = '+hms(v).replace(/(\d+):(\d+):(\d+)/,'$1h$2m$3s');
}
function doGoTo(){
  var ra=raDeg(), dec=decDeg(); if(ra===null||dec===null)return;
  fetch('/goto?ra='+ra+'&dec='+dec)
    .then(r=>r.text()).then(t=>{if(t!='OK')alert(t);poll();});
}
function setPark(){
  fetch('/set-park').then(r=>r.text()).then(t=>{alert(t=='OK'?'Положение парковки сохранено':t);poll();});
}
/* Труба на полюсе (противовес вниз): принять это положение за дом,
   плюс текущие координаты полюса в поля GoTo/Sync. Планетарии увидят
   новую позицию при следующем опросе (:GR#/:GD#, /api/get). */
function polarSet(){
  fetch('/set-home').then(()=>fetch('/status')).then(r=>r.json()).then(d=>{
    document.getElementById('gotoRA').value=hms(d.ra_deg);
    document.getElementById('gotoDEC').value='+90 00 00';
    raHint(); decHint(); poll();
    if(!d.time_ok)alert('Время не задано — RA полюса будет неверным');
  });
}
function doSync(){
  var ra=raDeg(), dec=decDeg(); if(ra===null||dec===null)return;
  fetch('/sync?ra='+ra+'&dec='+dec)
    .then(r=>r.text()).then(t=>{if(t!='OK')alert(t);poll();});
}

function homeSearch(cal){
  if(!confirm(cal?'Координаты точно привязаны? Ось DEC поедет к магниту, его положение будет сохранено':
                  'Привязать DEC по датчику? Ось DEC поедет к магниту'))return;
  fetch('/home-search'+(cal?'?calibrate=1':'')).then(r=>r.text()).then(t=>{if(t!='OK')alert(t);poll();});
}
function landmark(a){
  if(a=='sync'&&!confirm('Труба точно наведена на антенну?'))return;
  fetch('/landmark?do='+a).then(poll);
}

/* ── Park ── */
function doPark()  {fetch('/park').then(poll);}
function doUnpark(){fetch('/unpark').then(poll);}

/* ── DEC Hold ── */
function setDecHold(on){
  fetch('/dec-hold?enable='+(on?'1':'0'))
    .then(r=>r.json()).then(d=>updateDecHoldUI(d.dec_hold));
}
function updateDecHoldUI(on){
  var l=document.getElementById('decHoldLabel');
  document.getElementById('decHoldChk').checked=on;
  l.innerText=on?'DEC Hold ON':'DEC Hold OFF';
  l.style.color=on?'#10b981':'#f59e0b';
}

/* ── Настройки моторов ── */
function applyMotor(axis){
  var spd=document.getElementById(axis+'Spd').value;
  var acc=document.getElementById(axis+'Acc').value;
  fetch('/motor?axis='+axis+'&speed='+spd+'&accel='+acc)
    .then(r=>r.json()).then(d=>{
      alert(d.ok?axis.toUpperCase()+' OK':'Error: '+d.error);
    });
}

/* ── Emergency stop ── */
function emergencyStop(){
  fetch('/estop').then(poll);
  trackOn=false;
  var b=document.getElementById('trackBtn');
  b.innerText='▶ Start Tracking';
  b.className='btn-track';
}

/* ── Схема монтировки ──
   3D-модель в осях (восток, север, вверх), единица — длина половины трубы.
   Ось RA смотрит на полюс; противовес — по оси DEC, в доме (mech HA = −90°)
   вниз; труба: cos(d)·экватор(h) + sin(d)·полюс, при d > 90° — за полюс. */
var RD=Math.PI/180, mPrev='', mFast=false;
function eqv(H,d,lat){
  H*=RD; d*=RD; var f=lat*RD;
  return [-Math.cos(d)*Math.sin(H),
          Math.sin(d)*Math.cos(f)-Math.cos(d)*Math.cos(H)*Math.sin(f),
          Math.sin(d)*Math.sin(f)+Math.cos(d)*Math.cos(H)*Math.cos(f)];
}
function va(a,b,k){return [a[0]+b[0]*k,a[1]+b[1]*k,a[2]+b[2]*k];}
var MS=55;   // пикселей на единицу
// Виды: точка → [x, y, глубина к зрителю]
var VIEWS={
  side:function(v){return [-v[1]*MS, -v[2]*MS+15, -v[0]];}, // с запада: север влево
  top: function(v){return [v[0]*MS, -v[1]*MS+10, v[2]];}    // сверху: север вверх, восток вправо
};
function f1(x){return x.toFixed(1);}
function seg(a,b,w,col,cap){
  return '<line x1="'+f1(a[0])+'" y1="'+f1(a[1])+'" x2="'+f1(b[0])+'" y2="'+f1(b[1])+'" stroke="'+col+'" stroke-width="'+w+'" stroke-linecap="'+(cap||'round')+'"/>';
}
// Дуга с красными стрелками от угла a1 к a2 (градусы экрана): короткой стороной,
// а при cw — всегда по часовой (азимут от севера)
function arc(c,r,a1,a2,label,cw){
  var dl=cw?((a2-a1+720)%360):((a2-a1+540)%360)-180;
  if(Math.abs(dl)<6||dl>354) return '';
  // Линия дуги кончается у основания наконечника, остриё — точно в a1/a2
  var hl=Math.min(15,r*Math.abs(dl)*RD*0.4), tr=hl/r/RD*(dl>0?1:-1);
  function pt(a){return [c[0]+r*Math.cos(a*RD),c[1]+r*Math.sin(a*RD)];}
  function head(tip,base){
    var ux=tip[0]-base[0], uy=tip[1]-base[1], n=Math.hypot(ux,uy), w=hl*0.6;
    ux/=n; uy/=n;
    return '<polygon points="'+f1(tip[0])+','+f1(tip[1])+' '+f1(base[0]-uy*w)+','+f1(base[1]+ux*w)+' '+f1(base[0]+uy*w)+','+f1(base[1]-ux*w)+'" fill="#ff3b3b"/>';
  }
  var p1=pt(a1+tr), p2=pt(a2-tr), am=(a1+dl/2)*RD;
  return '<path d="M'+f1(p1[0])+','+f1(p1[1])+' A'+r+','+r+' 0 '+(Math.abs(dl)-2*Math.abs(tr)>180?1:0)+' '+(dl>0?1:0)+' '+f1(p2[0])+','+f1(p2[1])+'" fill="none" stroke="#ff3b3b" stroke-width="5"/>'+
    head(pt(a1),p1)+head(pt(a2),p2)+
    '<text x="'+f1(c[0]+(r+24)*Math.cos(am))+'" y="'+f1(c[1]+(r+20)*Math.sin(am)+4)+'" fill="#ff5c5c" font-size="13" font-weight="600" text-anchor="middle" stroke="#0b1020" stroke-width="3" paint-order="stroke">'+label+'</text>';
}
// Труба: прямоугольник с градиентом поперёк, торцы; ближний к зрителю торец — эллипс
function tube(b,f,full,w){
  var dx=f[0]-b[0], dy=f[1]-b[1], L=Math.hypot(dx,dy), ang=Math.atan2(dy,dx)/RD;
  var cx=(b[0]+f[0])/2, cy=(b[1]+f[1])/2, k=Math.min(L/full,1);
  var s='<g transform="translate('+f1(cx)+','+f1(cy)+') rotate('+f1(ang)+')">'+
    '<rect x="'+f1(-L/2)+'" y="'+(-w/2)+'" width="'+f1(L)+'" height="'+w+'" fill="url(#mTube)"/>';
  if(L>40) s+='<rect x="'+f1(-L/2)+'" y="'+(-w/2)+'" width="9" height="'+w+'" fill="url(#mCap)"/>'+
              '<rect x="'+f1(L/2-9)+'" y="'+(-w/2)+'" width="9" height="'+w+'" fill="url(#mCap)"/>';
  var front=f[2]>b[2], rx=Math.max(w/2*Math.sqrt(1-k*k),1);
  s+='<ellipse cx="'+f1(front?L/2:-L/2)+'" cy="0" rx="'+f1(rx)+'" ry="'+(w/2)+'" fill="'+(front?'#0b1020':'#555')+'" stroke="'+(front?'#5b6bff':'#999')+'" stroke-width="2"/>';
  return s+'</g>';
}
// Синяя стрелка направления трубы; почти на зрителя — ⊙, от зрителя — ⊗
function pointer(f,dir,full){
  var L=Math.hypot(dir[0],dir[1]), k=L/full;
  if(k<0.25){
    var t=dir[2]>0;
    return '<circle cx="'+f1(f[0])+'" cy="'+f1(f[1])+'" r="9" fill="none" stroke="#5b6bff" stroke-width="3"/>'+
      (t?'<circle cx="'+f1(f[0])+'" cy="'+f1(f[1])+'" r="3" fill="#5b6bff"/>'
        :seg([f[0]-5,f[1]-5],[f[0]+5,f[1]+5],3,'#5b6bff')+seg([f[0]-5,f[1]+5],[f[0]+5,f[1]-5],3,'#5b6bff'));
  }
  var ux=dir[0]/L, uy=dir[1]/L, n=40*k, e=[f[0]+ux*n,f[1]+uy*n];
  return seg(f,e,8,'#5b6bff','butt')+
    '<polygon points="'+f1(e[0]+ux*16)+','+f1(e[1]+uy*16)+' '+f1(e[0]-uy*11)+','+f1(e[1]+ux*11)+' '+f1(e[0]+uy*11)+','+f1(e[1]-ux*11)+'" fill="#5b6bff"/>';
}
var MDEFS='<defs>'+
  '<linearGradient id="mTube" x1="0" y1="0" x2="0" y2="1"><stop offset="0" stop-color="#111"/>'+
  '<stop offset=".3" stop-color="#f4f4f4"/><stop offset=".55" stop-color="#aaa"/><stop offset="1" stop-color="#111"/></linearGradient>'+
  '<linearGradient id="mCap" x1="0" y1="0" x2="0" y2="1"><stop offset="0" stop-color="#000"/>'+
  '<stop offset=".4" stop-color="#888"/><stop offset="1" stop-color="#000"/></linearGradient>'+
  '<linearGradient id="mRod" x1="0" y1="0" x2="1" y2="0"><stop offset="0" stop-color="#222"/>'+
  '<stop offset=".5" stop-color="#ddd"/><stop offset="1" stop-color="#222"/></linearGradient></defs>';
function drawView(id,pr,m,extra){
  var P=m.P, items=[];
  function it(z,svg){items.push([z,svg]);}
  var A0=va([0,0,0],P,-0.45), A1=va([0,0,0],P,0.3), G=[A0[0],A0[1],-1.9];
  var cw0=va(A1,m.cw,-0.25), cwE=va(A1,m.cw,1.15), W=va(A1,m.cw,0.95);
  var T=va(A1,m.cw,-0.32), B=va(T,m.t,-0.95), F=va(T,m.t,1.0);
  var pA0=pr(A0),pA1=pr(A1),pG=pr(G),pc0=pr(cw0),pcE=pr(cwE),pW=pr(W),pT=pr(T),pB=pr(B),pF=pr(F);
  it((pG[2]+pA0[2])/2, seg(pG,pA0,10,'#666','butt'));                   // опора
  it((pA0[2]+pA1[2])/2, seg(pA0,pA1,16,'#9aa','round'));               // ось RA
  it((pA1[2]+pcE[2])/2-0.01, seg(pA1,pcE,6,'#bbb','round'));           // штанга
  it(pW[2], '<circle cx="'+f1(pW[0])+'" cy="'+f1(pW[1])+'" r="13" fill="#444" stroke="#999" stroke-width="2"/>');
  it((pc0[2]+pA1[2])/2+0.01, seg(pc0,pA1,13,'#778','round'));          // ось DEC
  it(pT[2], tube(pB,pF,1.95*MS,26));
  items.sort(function(a,b){return a[0]-b[0];});
  var s=MDEFS+extra(pT,pF,pA0,pA1);
  items.forEach(function(x){s+=x[1];});
  s+=pointer(pF,[pF[0]-pB[0],pF[1]-pB[1],pF[2]-pB[2]],1.95*MS);
  s+=m.arc(pT,pB,pF);
  document.getElementById(id).innerHTML=s;
}
function drawMount(d){
  var h=d.mech_ha, dm=d.mech_dec, lat=d.lat;
  var P=eqv(0,90,lat), E=eqv(h,0,lat), cw=eqv(h-90,0,lat);
  var t=[0,1,2].map(function(i){return Math.cos(dm*RD)*E[i]+Math.sin(dm*RD)*P[i];});
  var m={P:P,cw:cw,t:t};
  // Сбоку: горизонт, ось на полюс; дуга — высота над горизонтом
  m.arc=function(pT,pB,pF){
    var a2=Math.atan2(pF[1]-pB[1],pF[0]-pB[0])/RD, a1=(pF[0]>=pB[0])?0:180;
    return arc(pT,72,a1,a2,'Alt '+d.alt.toFixed(1)+'°');
  };
  drawView('mSide',VIEWS.side,m,function(pT,pF,pA0,pA1){
    var pole=VIEWS.side(va([0,0,0],P,2.4)), g=-1.9*MS*-1+15;
    return '<line x1="-150" y1="'+g+'" x2="150" y2="'+g+'" stroke="#3a5" stroke-width="2"/>'+
      '<line x1="-150" y1="'+f1(pT[1])+'" x2="150" y2="'+f1(pT[1])+'" stroke="#ff3b3b" stroke-width="1" stroke-dasharray="4 4" opacity=".6"/>'+
      seg(pA0,pole,1,'#ff3b3b')+
      '<text x="'+f1(pole[0]-4)+'" y="'+f1(pole[1]+4)+'" fill="#ff7b7b" font-size="11" text-anchor="end">полюс</text>'+
      '<text x="-144" y="'+(g-6)+'" fill="#6c8" font-size="12">N</text>'+
      '<text x="136" y="'+(g-6)+'" fill="#6c8" font-size="12">S</text>';
  });
  // Сверху: роза ветров; дуга — азимут от севера
  m.arc=function(pT,pB,pF){
    var a2=Math.atan2(pF[1]-pB[1],pF[0]-pB[0])/RD;
    return arc(pT,72,-90,a2,'Az '+d.az.toFixed(1)+'°',true);
  };
  drawView('mTop',VIEWS.top,m,function(pT){
    return '<line x1="'+f1(pT[0])+'" y1="-125" x2="'+f1(pT[0])+'" y2="'+f1(pT[1])+'" stroke="#ff3b3b" stroke-width="1" stroke-dasharray="4 4" opacity=".6"/>'+
      '<text x="0" y="-110" fill="#6c8" font-size="13" text-anchor="middle">N</text>'+
      '<text x="0" y="120" fill="#6c8" font-size="13" text-anchor="middle">S</text>'+
      '<text x="140" y="5" fill="#6c8" font-size="13" text-anchor="middle">E</text>'+
      '<text x="-140" y="5" fill="#6c8" font-size="13" text-anchor="middle">W</text>';
  });
  document.getElementById('mVals').innerHTML=
    'Alt <b>'+d.alt.toFixed(1)+'°</b> · Az <b>'+d.az.toFixed(1)+'°</b> · Pier <b>'+d.pier+'</b>'+
    '<br>Механика: HA <b>'+h.toFixed(2)+'°</b> · DEC <b>'+dm.toFixed(2)+'°</b>'+
    (d.hall?' · <span style="color:#10b981">🧲 метка</span>':'');
  // Пока оси движутся — опрашиваем чаще, чтобы схема шла плавно
  var key=h.toFixed(3)+'/'+dm.toFixed(3);
  mFast=d.slewing||(mPrev!==''&&key!==mPrev);
  mPrev=key;
}

setInterval(poll,2000);
setInterval(function(){if(mFast)poll();},400);
poll();
</script>
</body>
</html>
)rawliteral";

// ============================================================
//  TMC2209: настройка и контроль по UART
// ============================================================
bool tmcInit(TMC2209Stepper& drv, const char* name, int currentMa) {
    Serial.printf("TMC %s: ", name);
    uint8_t conn = drv.test_connection();
    if (conn != 0) {
        Serial.printf("нет ответа (код %u)\n", conn);
        return false;
    }
    drv.GSTAT(0b111);              // сброс флагов reset/drv_err/uv_cp
    drv.pdn_disable(true);         // PDN_UART — только UART, не power-down
    drv.mstep_reg_select(true);    // микрошаг из регистра, MS1/MS2 — адрес
    drv.I_scale_analog(false);     // ток задаётся только по UART, VREF игнорируется
    drv.toff(4);
    drv.blank_time(24);
    drv.microsteps(MICROSTEPS);
    drv.intpol(true);
    drv.rms_current(currentMa);
    drv.en_spreadCycle(false);     // StealthChop — тихий режим
    drv.pwm_autoscale(true);

    uint32_t ds = drv.DRV_STATUS();
    Serial.printf("OK, версия 0x%02X, микрошаг 1/%u, ток %u мА, IFCNT %u",
                  drv.version(), drv.microsteps(), drv.rms_current(), drv.IFCNT());
    if (ds & (1UL << 1))  Serial.print(F(", ПЕРЕГРЕВ"));
    if (ds & (1UL << 0))  Serial.print(F(", предупреждение о температуре"));
    if (ds & (0b1111UL << 2)) Serial.print(F(", КЗ обмотки"));
    if (ds & (0b11UL << 6))   Serial.print(F(", обмотка не подключена"));
    Serial.println();
    return drv.microsteps() == MICROSTEPS;
}

// Раз в 5 с: переподключаем пропавший драйвер (например, 12 В подали
// позже ESP) и переинициализируем после сброса чипа. Во время
// движения шину не трогаем — чтение блокирует loop() на пару мс.
void tmcCheck(TMC2209Stepper& drv, bool& ok, const char* name, int currentMa) {
    if (ok) {
        if (drv.test_connection() != 0) {
            Serial.printf("TMC %s: связь потеряна\n", name);
            ok = false;
        } else if (drv.GSTAT() & 0b001) {
            Serial.printf("TMC %s: был сброс, настраиваю заново\n", name);
            ok = tmcInit(drv, name, currentMa);
        }
    } else if (drv.test_connection() == 0) {   // молча ждём, пока ответит
        ok = tmcInit(drv, name, currentMa);
    }
}

// Диагностика драйвера по сети: GET /tmc. Флаги ola/olb (обмотка не
// подключена) и cs_actual осмысленны только при работающем моторе.
String tmcJson(TMC2209Stepper& drv, bool ok) {
    if (!ok || drv.test_connection() != 0) return "{\"ok\":false}";
    uint32_t ds = drv.DRV_STATUS();
    auto flag = [ds](int n) { return (ds >> n) & 1UL ? "true" : "false"; };
    String j = "{\"ok\":true";
    j += ",\"enabled\":"   + String(drv.isEnabled() ? "true" : "false");
    j += ",\"microsteps\":" + String(drv.microsteps());
    j += ",\"rms_ma\":"    + String(drv.rms_current());
    j += ",\"cs_actual\":" + String((ds >> 16) & 0x1F);
    j += ",\"stealth\":"   + String(flag(30));
    j += ",\"standstill\":" + String(flag(31));
    j += ",\"ola\":" + String(flag(6)) + ",\"olb\":" + String(flag(7));
    j += ",\"s2ga\":" + String(flag(2)) + ",\"s2gb\":" + String(flag(3));
    j += ",\"otpw\":" + String(flag(0)) + ",\"ot\":" + String(flag(1));
    j += ",\"t120\":" + String(flag(8));
    j += ",\"sg_result\":" + String(drv.SG_RESULT());
    j += ",\"ifcnt\":"     + String(drv.IFCNT());
    j += "}";
    return j;
}

void handleTmc() {
    String j = "{\"ra\":" + tmcJson(drvRA, raDrvOk) +
               ",\"dec\":" + tmcJson(drvDEC, decDrvOk) + "}";
    server.send(200, "application/json", j);
}

// Поиск неисправности шины: GET /tmc-scan. Уровень линии в покое
// (0 — узел PDN закорочен на GND) и ответ по каждому адресу 0..3:
// 0 — ответил, 1 — читается 0xFFFFFFFF, 2 — нет ответа.
void handleTmcScan() {
    String j = "{\"line_idle\":" + String(digitalRead(TMC_UART_PIN));
    for (uint8_t addr = 0; addr < 4; addr++) {
        TMC2209Stepper probe(&tmcBus, TMC_RSENSE, addr);
        uint8_t conn = probe.test_connection();
        j += ",\"addr" + String(addr) + "\":{\"conn\":" + String(conn);
        if (conn == 0) j += ",\"version\":" + String(probe.version());
        j += "}";
    }
    j += "}";
    server.send(200, "application/json", j);
}

// ============================================================
//  SETUP
// ============================================================
void setup() {
    Serial.begin(115200);
    Serial.println(F("\n============================"));
    Serial.println(F(" EQ2 Mount Controller v6.0  "));
    Serial.println(F(" RTS2 + LX200/OnStep TCP    "));
    Serial.println(F("============================\n"));

    pinMode(RA_ENABLE_PIN,  OUTPUT); digitalWrite(RA_ENABLE_PIN,  HIGH);
    pinMode(DEC_ENABLE_PIN, OUTPUT); digitalWrite(DEC_ENABLE_PIN, HIGH);
    pinMode(DEC_HOME_PIN, INPUT);   // INPUT_PULLUP на GPIO16 не работает
    hallRaw = hallActive = digitalRead(DEC_HOME_PIN) == LOW;
    Serial.printf("Hall DEC: %s\n", hallActive ? "magnet" : "clear");

    tmcSerial.begin(TMC_BAUD, SWSERIAL_8N1, TMC_UART_PIN, TMC_UART_PIN, false);
    raDrvOk  = tmcInit(drvRA,  "RA",  RA_CURRENT_MA);
    decDrvOk = tmcInit(drvDEC, "DEC", DEC_CURRENT_MA);
    lastTmcCheck = millis();

    stepperRA .setMaxSpeed(raMaxSpeed);  stepperRA .setAcceleration(raAccel);
    stepperDEC.setMaxSpeed(decMaxSpeed); stepperDEC.setAcceleration(decAccel);
    // После включения монтировка считается в положении парковки (если оно
    // сохранено — её паркуют перед выключением) и запаркованной; иначе в доме.
    EEPROM.begin(HALL_EEPROM_ADDR + sizeof(HallMarkData));
    loadHallMark();
    if (loadPark()) {
        stepperRA .setCurrentPosition(parkRA);
        stepperDEC.setCurrentPosition(parkDEC);
        isParked = true;
        Serial.println(F("Position: saved park, parked"));
    } else {
        setHomePosition();
    }

    // Режим не пишем во флеш: иначе после запуска точки доступа ESP так и
    // остаётся в AP+STA и радио прыгает по каналам. Сон модема выключаем —
    // с ним ESP теряет пакеты и кнопки веб-интерфейса «не срабатывают».
    WiFi.persistent(false);
    WiFi.mode(WIFI_STA);
    WiFi.setSleepMode(WIFI_NONE_SLEEP);
    WiFi.setAutoReconnect(true);
    WiFi.begin(ssid, password);
    Serial.print(F("WiFi connecting"));
    for (int i = 0; i < 40 && WiFi.status() != WL_CONNECTED; i++) {
        delay(500); Serial.print('.');
    }
    if (WiFi.status() == WL_CONNECTED) {
        Serial.println();
        Serial.print(F("IP: ")); Serial.println(WiFi.localIP());
        Serial.println("Web UI:   http://" + WiFi.localIP().toString() + "/");
        Serial.println("RTS2:     http://" + WiFi.localIP().toString() + "/api/...");
        Serial.println("LX200:    " + WiFi.localIP().toString() + ":4030");
        Serial.println("OTA:      http://" + WiFi.localIP().toString() + "/update");
        settimeofday_cb([](bool fromSntp) { if (fromSntp) timeSource = 2; });
        configTime(0, 0, "pool.ntp.org", "time.google.com");
    } else {
        Serial.println(F("\nWiFi failed — AP mode: EQ2-Mount / telescope"));
        WiFi.softAP("EQ2-Mount", "telescope");
        Serial.print(F("AP IP: ")); Serial.println(WiFi.softAPIP());
    }

    // Web UI маршруты
    server.on("/",         HTTP_GET, []{ server.send_P(200, "text/html", htmlPage); });
    server.on("/status",   HTTP_GET, handleStatus);
    server.on("/tracking", HTTP_GET, handleTracking);
    server.on("/ra-speed", HTTP_GET, handleRASpeed);
    server.on("/jog",      HTTP_GET, handleJog);
    server.on("/stop-all", HTTP_GET, handleStopAll);
    server.on("/goto",     HTTP_GET, handleGoTo);
    server.on("/sync",     HTTP_GET, handleSync);
    server.on("/landmark", HTTP_GET, handleLandmark);
    server.on("/set-home", HTTP_GET, handleSetHome);
    server.on("/home-search", HTTP_GET, handleHomeSearch);
    server.on("/set-park", HTTP_GET, handleSetPark);
    server.on("/set-time", HTTP_GET, handleSetTime);
    server.on("/park",     HTTP_GET, handlePark);
    server.on("/unpark",   HTTP_GET, handleUnpark);
    server.on("/motor",    HTTP_GET, handleMotor);
    server.on("/estop",    HTTP_GET, handleEStop);
    server.on("/dec-hold",  HTTP_GET, handleDecHold);
    server.on("/tmc",      HTTP_GET, handleTmc);
    server.on("/tmc-scan", HTTP_GET, handleTmcScan);

    // RTS2 JSON API (Stellarium TelescopeClientJsonRts2)
    server.on("/api/devbytype",  HTTP_GET, rts2_devbytype);
    server.on("/api/deviceinfo", HTTP_GET, rts2_deviceinfo);
    server.on("/api/get",        HTTP_GET, rts2_get);
    server.on("/api/cmd",        HTTP_GET, rts2_cmd);

    ElegantOTA.begin(&server);
    server.begin();
    Serial.println(F("HTTP server started."));

    // LX200/OnStep TCP сервер
    lxTcpServer.begin();
    lxTcpServer.setNoDelay(true);
    Serial.println(F("LX200 TCP server started on port 4030.\n"));
}

// ============================================================
//  LOOP
// ============================================================
void loop() {
    server.handleClient();
    ElegantOTA.loop();

    const unsigned long now = millis();

    // — Контроль драйверов TMC2209 —
    if (now - lastTmcCheck > 5000 && !isSlewing && !raMoving && !decMoving) {
        lastTmcCheck = now;
        tmcCheck(drvRA,  raDrvOk,  "RA",  RA_CURRENT_MA);
        tmcCheck(drvDEC, decDrvOk, "DEC", DEC_CURRENT_MA);
    }

    if (raGuideSpeed != 0.0f && (long)(now - raGuideEnd) >= 0) raGuideSpeed = 0.0f;

    // — RA: GoTo (run() с разгоном) или постоянная скорость (трекинг + джог + гидирование) —
    if (raSlew) {
        if (!stepperRA.run()) raSlew = false;
        raStopTime = now;
    } else {
        float sps = (raManualSpeed + raGuideSpeed) * RA_STEPS_PER_DEG * RA_DIR;
        if (trackingEnabled) sps += RA_SIDEREAL_SPEED * raSpeedMult * RA_DIR;
        if (sps != 0.0f) {
            enableRA(true);
            stepperRA.setSpeed(sps);
            stepperRA.runSpeed();
            raMoving = true; raStopTime = now;
        } else if (raMoving && now - raStopTime > MOTOR_OFF_DELAY) {
            enableRA(false); raMoving = false;
        }
    }

    // — Датчик Холла DEC: уровень должен продержаться HALL_DEBOUNCE_MS —
    bool raw = digitalRead(DEC_HOME_PIN) == LOW;
    if (raw != hallRaw) { hallRaw = raw; hallRawTime = now; }
    else if (raw != hallActive && now - hallRawTime >= HALL_DEBOUNCE_MS) {
        hallActive = raw;
        hallEdges++;
        double d = mechDEC();
        if (raw) hallEnterDEC = d; else hallExitDEC = d;
        Serial.printf("Hall DEC: %s at mech DEC %.3f\n", raw ? "magnet" : "clear", d);
    }

    // — DEC: GoTo или джог. Джог механический, независимо от положения трубы:
    //   + всегда в одну сторону оси, − в другую, по кругу через полюс.
    //   Мотор DEC после остановки не выключаем, если включено удержание —
    if (decSlew) {
        if (!stepperDEC.run()) decSlew = false;
        decStopTime = now;
    } else if (homeState != HOME_IDLE) {
        // Поиск Home: джог (:Mn#/:Ms#) его прерывает, гидирование ждёт
        decGuideAcc = 0; decGuideMove = false;
        if (decManualSpeed != 0.0f) homeFail("ручное движение DEC");
        else                        homeSearchStep();
        decMoving = true; decStopTime = now;
    } else if (decManualSpeed != 0.0f) {
        decGuideAcc = 0; decGuideMove = false;   // джог отменяет поправки гидирования
        enableDEC(true);
        stepperDEC.setSpeed(decManualSpeed * DEC_STEPS_PER_DEG * DEC_DIR);
        stepperDEC.runSpeed();
        // Полный оборот: держим механический DEC в (−90°, 270°]
        double d = mechDEC();
        if (d > 270.0 || d <= -90.0) {
            long turn = lround(360.0 * DEC_STEPS_PER_DEG * DEC_DIR);
            stepperDEC.setCurrentPosition(stepperDEC.currentPosition() + (d > 270.0 ? -turn : turn));
        }
        decMoving = true; decStopTime = now;
    } else if (decGuideMove || fabs(decGuideAcc) >= 1.0f) {
        // Гидирование DEC: накопился целый шаг — делаем его
        if (!decGuideMove) {
            long n = (long)decGuideAcc;
            decGuideAcc -= n;
            enableDEC(true);
            stepperDEC.move(n * DEC_DIR);
            decGuideMove = true;
        }
        if (!stepperDEC.run()) decGuideMove = false;
        decMoving = true; decStopTime = now;
    } else if (decMoving && now - decStopTime > MOTOR_OFF_DELAY) {
        decMoving = false;
        if (!decHoldEnabled) enableDEC(false);
    }

    // — Доводка GoTo: пока оси шли, небо сместилось —
    if (gotoPending && !raSlew && !decSlew) {
        double h = mechHA(), d = mechDEC(), th, td;
        eqToMech(targetRA_deg, targetDEC_deg, pierFlipped(d), h, th, td);
        if (++gotoPass < 4 && fabs(th - h) * RA_STEPS_PER_DEG > 32) {
            startSlewMech(th, td);
        } else {
            gotoPending = false;
        }
    }

    if (homeState == HOME_CENTER) homeSearchStep();   // доезд в 90° закончен?

    isSlewing = raSlew || decSlew || gotoPending || homeState != HOME_IDLE;

    // — Park: оси дошли до положения парковки —
    if (parkPending && !isSlewing) {
        parkPending = false;
        isParked    = true;
        Serial.println(F("Parked"));
    }

    updateCurrentCoords();
    lxHandleTCP();
}

// ============================================================
//  ВЕБ-ОБРАБОТЧИКИ
// ============================================================
void handleStatus() {
    // Тернарный оператор ?"true":"false" внутри строковой конкатенации
    // вызывает ошибку C++11 UDL (user-defined literal): компилятор считает
    // "" началом суффикса. Решение — вынести результат в const char*.
    const char* sTracking = trackingEnabled ? "true" : "false";
    const char* sSlewing  = isSlewing       ? "true" : "false";
    const char* sParked   = isParked        ? "true" : "false";
    const char* sDecHold  = decHoldEnabled  ? "true" : "false";

    String j = "{";
    j += "\"ra_deg\":"   + String(currentRA_deg,  6) + ",";
    j += "\"dec_deg\":"  + String(currentDEC_deg, 6) + ",";
    j += "\"tracking\":" + String(sTracking)         + ",";
    j += "\"slewing\":"  + String(sSlewing)          + ",";
    j += "\"parked\":"   + String(sParked)           + ",";
    j += "\"dec_hold\":" + String(sDecHold)          + ",";
    j += "\"ra_speed\":" + String(raSpeedMult, 3)    + ",";
    j += "\"fw\":\"" __DATE__ " " __TIME__ "\",";
    j += "\"up\":"     + String(millis() / 1000)  + ",";
    double alt, az;
    altAz(currentRA_deg, currentDEC_deg, alt, az);
    bool westSide = !pierFlipped(mechDEC()) == (HOME_HA_DEG < 0);
    j += "\"lst\":"      + String(lstDeg(), 4)      + ",";
    j += "\"alt\":"      + String(alt, 2)           + ",";
    j += "\"az\":"       + String(az, 2)            + ",";
    j += "\"pier\":\""  + String(westSide ? "W" : "E") + "\",";
    j += "\"time_ok\":"  + String(timeSource ? "true" : "false") + ",";
    j += "\"time_src\":" + String(timeSource)       + ",";
    j += "\"ra_drv\":"   + String(raDrvOk  ? "true" : "false") + ",";
    j += "\"dec_drv\":"  + String(decDrvOk ? "true" : "false") + ",";
    j += "\"rssi\":"     + String(WiFi.RSSI())             + ",";
    j += "\"heap\":"     + String(ESP.getFreeHeap())       + ",";
    j += "\"heap_max\":" + String(ESP.getMaxFreeBlockSize()) + ",";
    j += "\"hall\":"       + String(hallActive ? 1 : 0)  + ",";
    j += "\"hall_raw\":"   + String(digitalRead(DEC_HOME_PIN) == LOW ? 1 : 0) + ",";
    j += "\"hall_edges\":" + String(hallEdges)           + ",";
    j += "\"hall_in\":"    + (isnan(hallEnterDEC) ? String("null") : String(hallEnterDEC, 3)) + ",";
    j += "\"hall_out\":"   + (isnan(hallExitDEC)  ? String("null") : String(hallExitDEC,  3)) + ",";
    j += "\"mech_dec\":"   + String(mechDEC(), 3)        + ",";
    j += "\"mech_ha\":"    + String(mechHA(), 3)         + ",";
    j += "\"lat\":"        + String(obsLatitude_deg, 3)  + ",";
    j += "\"homing\":"     + String((int)homeState)      + ",";
    j += "\"hall_mark\":"  + String(hallMarkDEC, 3)      + ",";
    j += "\"home_msg\":\"" + homeMsg                     + "\",";
    j += "\"ip\":\""     + WiFi.localIP().toString() + "\"";
    j += "}";
    server.send(200, "application/json", j);
}

void handleTracking() {
    bool en = server.hasArg("enable") && server.arg("enable") == "1";
    trackingEnabled = en;
    if (en) enableRA(true);   // выключит loop(), когда ось постоит
    else    raManualSpeed = 0;
    server.send(200, "text/plain", "OK");
}

void handleRASpeed() {
    if (server.hasArg("speed"))
        raSpeedMult = server.arg("speed").toFloat();
    server.send(200, "text/plain", "OK");
}

void handleJog() {
    String axis = server.hasArg("axis")  ? server.arg("axis")  : "";
    float  spd  = server.hasArg("speed") ? server.arg("speed").toFloat() : 0;
    // RA: + на запад (механически), DEC: + в одну сторону оси (механически).
    // ?axis=ra|dec&speed= — одна ось; ?ra=&dec= — обе сразу (диагональ)
    bool hasRA = axis == "ra"  || server.hasArg("ra");
    bool hasDE = axis == "dec" || server.hasArg("dec");
    float raSpd  = server.hasArg("ra")  ? server.arg("ra").toFloat()  : spd;
    float decSpd = server.hasArg("dec") ? server.arg("dec").toFloat() : spd;
    if ((hasRA && raSpd != 0) || (hasDE && decSpd != 0)) haltSlew();
    if (hasRA) { raManualSpeed  = raSpd;  raStopTime  = millis(); }
    if (hasDE) { decManualSpeed = decSpd; decStopTime = millis(); }
    server.send(200, "text/plain", "OK");
}

void handleStopAll() {
    trackingEnabled = false;
    raManualSpeed   = 0;
    decManualSpeed  = 0;
    haltSlew();             // моторы выключит loop() после торможения
    raStopTime = decStopTime = millis();
    server.send(200, "text/plain", "OK");
}

void handleGoTo() {
    if (server.hasArg("ra") && server.hasArg("dec")) {
        if (!startGoTo(server.arg("ra").toDouble(), server.arg("dec").toDouble())) {
            server.send(400, "text/plain",
                        timeSource ? "Цель ниже горизонта" : "Время не задано");
            return;
        }
    }
    server.send(200, "text/plain", "OK");
}

void handleSync() {
    if (server.hasArg("ra") && server.hasArg("dec")) {
        if (!syncTo(server.arg("ra").toDouble(), server.arg("dec").toDouble())) {
            server.send(400, "text/plain", "Время не задано");
            return;
        }
    }
    server.send(200, "text/plain", "OK");
}

// GET /landmark?do=sync|goto — привязка к ориентиру / наведение на него
void handleLandmark() {
    String a = server.arg("do");
    if      (a == "sync") syncLandmark();
    else if (a == "goto") gotoLandmark();
    else { server.send(400, "text/plain", "do=sync|goto"); return; }
    server.send(200, "text/plain", "OK");
}

// GET /home-search[?dir=1|-1][&calibrate=1] — привязка DEC по метке датчика
// Холла (без dir — к метке); calibrate — измерить метку и сохранить во флеш
void handleHomeSearch() {
    int dir = server.hasArg("dir") ? server.arg("dir").toInt() : 0;
    bool cal = server.arg("calibrate") == "1";
    server.send(200, "text/plain", startHomeSearch(dir, cal) ? "OK" : homeMsg);
}

void handleSetHome() {
    setHomePosition();
    server.send(200, "text/plain", "OK");
}

void handleSetPark() {
    if (isSlewing)       server.send(200, "text/plain", "Монтировка движется — дождитесь остановки");
    else if (savePark()) server.send(200, "text/plain", "OK");
    else                 server.send(200, "text/plain", "Ошибка записи во флеш");
}

// GET /set-time?ms=<unix ms> — время из браузера, если нет NTP
void handleSetTime() {
    if (server.hasArg("ms") && timeSource < 2)
        setClock(server.arg("ms").toDouble() / 1000.0, 1);
    server.send(200, "application/json",
                String("{\"time_src\":") + timeSource + "}");
}

void handlePark() {
    parkMount();
    server.send(200, "text/plain", "OK");
}

void handleUnpark() {
    isParked = false;
    server.send(200, "text/plain", "OK");
}

void handleMotor() {
    if (!server.hasArg("axis")) {
        server.send(400,"application/json","{\"ok\":false,\"error\":\"no axis\"}");
        return;
    }
    String axis = server.arg("axis");
    float  spd  = server.hasArg("speed") ? server.arg("speed").toFloat() : -1;
    float  acc  = server.hasArg("accel") ? server.arg("accel").toFloat() : -1;
    if (spd < 10 || spd > 15000 || acc < 10 || acc > 10000) {
        server.send(400,"application/json","{\"ok\":false,\"error\":\"out of range\"}");
        return;
    }
    if (axis == "ra") {
        raMaxSpeed = spd; raAccel = acc;
        stepperRA.setMaxSpeed(spd); stepperRA.setAcceleration(acc);
    } else if (axis == "dec") {
        decMaxSpeed = spd; decAccel = acc;
        stepperDEC.setMaxSpeed(spd); stepperDEC.setAcceleration(acc);
    }
    server.send(200, "application/json", "{\"ok\":true}");
}

void handleEStop() {
    trackingEnabled = false;
    raManualSpeed   = 0;
    decManualSpeed  = 0;
    isSlewing       = false;
    abortSlew();
    enableRA(false);
    if (decHoldEnabled) {
        enableDEC(true);    // удержание включено — держим ось
    } else {
        enableDEC(false);   // удержание выключено — отключаем
    }
    raMoving = decMoving = false;
    Serial.println(F("!!! EMERGENCY STOP !!!"));
    server.send(200, "text/plain", "OK");
}

// Включение/выключение удержания оси DEC мотором
// GET /dec-hold?enable=1  или  GET /dec-hold?enable=0
void handleDecHold() {
    if (server.hasArg("enable")) {
        decHoldEnabled = (server.arg("enable") == "1");
        if (decHoldEnabled) {
            enableDEC(true);   // сразу включаем мотор
            Serial.println(F("DEC hold: ON"));
        } else {
            enableDEC(false);  // сразу отключаем мотор
            Serial.println(F("DEC hold: OFF"));
        }
    }
    // Пробел перед bool-значением обязателен — без него компилятор
    // трактует \"true\" как суффикс строкового литерала (C++11 UDL).
    const char* val = decHoldEnabled ? "true" : "false";
    String j = String("{\"dec_hold\":") + val + "}";
    server.send(200, "application/json", j);
}

// ============================================================
//  RTS2 JSON API
//  Реализован по исходнику TelescopeClientJsonRts2.cpp из Stellarium
// ============================================================

// GET /api/devbytype?t=2  → ["T0"]
void rts2_devbytype() {
    server.send(200, "application/json", "[\"T0\"]");
}

// GET /api/deviceinfo?d=T0  → {"readonly":false}
void rts2_deviceinfo() {
    server.send(200, "application/json", "{\"readonly\":false}");
}

// GET /api/get?d=T0
// Поля: d.TEL.ra (deg), d.TEL.dec (deg),
//       d.LONGITUD (deg), d.LATITUDE (deg),
//       d.ALTITUDE (m), d.target_distance (deg)
void rts2_get() {
    double dRA   = targetRA_deg  - currentRA_deg;
    double dDEC  = targetDEC_deg - currentDEC_deg;
    double tDist = sqrt(dRA*dRA + dDEC*dDEC);

    String j = "{\"d\":{";
    j += "\"TEL\":{\"ra\":"  + String(currentRA_deg,  6) +
                 ",\"dec\":" + String(currentDEC_deg, 6) + "},";
    j += "\"LONGITUD\":"        + String(obsLongitude_deg, 6) + ",";
    j += "\"LATITUDE\":"        + String(obsLatitude_deg,  6) + ",";
    j += "\"ALTITUDE\":"        + String(obsAltitude_m,    2) + ",";
    j += "\"target_distance\":" + String(tDist,            6);
    j += "}}";
    server.send(200, "application/json", j);
}

// GET /api/cmd?d=T0&c=move+RA_deg+DEC_deg
void rts2_cmd() {
    if (!server.hasArg("c")) {
        server.send(400, "application/json", "{\"ret\":1}");
        return;
    }
    String cmd = server.arg("c");
    bool isTLE  = cmd.startsWith("move_tle");
    bool isMove = cmd.startsWith("move") && !isTLE;

    if (isMove) {
        int s1 = cmd.indexOf(' ');
        int s2 = cmd.indexOf(' ', s1+1);
        if (s1 < 0 || s2 < 0) {
            server.send(200,"application/json","{\"ret\":1}"); return;
        }
        double ra  = cmd.substring(s1+1, s2).toDouble();
        double dec = cmd.substring(s2+1).toDouble();
        server.send(200, "application/json",
                    startGoTo(ra, dec) ? "{\"ret\":0}" : "{\"ret\":1}");
    } else if (isTLE) {
        // TLE для спутников — ESP8266 орбиту не считает,
        // сообщаем успех чтобы Stellarium не показывал ошибку
        server.send(200, "application/json", "{\"ret\":0}");
    } else {
        server.send(200, "application/json", "{\"ret\":1}");
    }
}

// ============================================================
//  LX200 / OnStep TCP HANDLER
// ============================================================
void lxHandleTCP() {
    if (lxTcpServer.hasClient()) {
        if (!lxClientConnected || !lxTcpClient.connected()) {
            if (lxTcpClient) lxTcpClient.stop();
            lxTcpClient       = lxTcpServer.available();
            lxClientConnected = true;
            lxTcpBuf          = "";
            Serial.println(F("LX200 TCP: client connected"));
        } else {
            WiFiClient extra = lxTcpServer.available();
            extra.stop();
        }
    }
    if (!lxClientConnected) return;
    if (!lxTcpClient.connected()) {
        lxTcpClient.stop();
        lxClientConnected = false;
        lxTcpBuf          = "";
        Serial.println(F("LX200 TCP: client disconnected"));
        return;
    }
    while (lxTcpClient.available()) {
        char c = lxTcpClient.read();
        if (c == 0x06) {
            // ACK (0x06) — пинг lx200driver, ответ 'P' (polar aligned)
            lxTcpClient.print('P');
            Serial.println(F("LX< ACK → P"));
            lxInCommand = false;
            lxTcpBuf    = "";
        } else if (c == ':') {
            // ':' — начало команды ТОЛЬКО если мы не внутри команды.
            // Если lxInCommand=true, значит ':' является частью аргумента
            // (например :Sr22:01:48# или :Sd-13*14:15#) — добавляем в буфер.
            if (!lxInCommand) {
                lxTcpBuf    = "";
                lxInCommand = true;
            } else {
                if (lxTcpBuf.length() < 32) lxTcpBuf += c;
            }
        } else if (c == '#') {
            // '#' — конец команды
            if (lxInCommand) {
                lxProcessCommand(lxTcpBuf);
            }
            lxTcpBuf    = "";
            lxInCommand = false;
        } else {
            // Обычный символ — добавляем в буфер только если внутри команды
            if (lxInCommand && lxTcpBuf.length() < 32)
                lxTcpBuf += c;
        }
    }
}

// ============================================================
//  LX200 ВСПОМОГАТЕЛЬНЫЕ ФУНКЦИИ
// ============================================================

// Импульс гидирования: d = n/s/e/w на ms миллисекунд со скоростью GUIDE_RATE_X.
// Запад — RA быстрее неба, восток — медленнее. Север/юг — по небу: за полюсом
// (после переворота) механическое направление DEC обратное.
bool startGuidePulse(char d, long ms) {
    if (ms <= 0 || isSlewing || isParked) return false;
    float v = SIDEREAL_RATE * GUIDE_RATE_X;
    if (d == 'e' || d == 'w') {
        enableRA(true);
        raGuideSpeed = (d == 'w') ? v : -v;
        raGuideEnd   = millis() + ms;
    } else if (d == 'n' || d == 's') {
        float sky = pierFlipped(mechDEC()) ? -1.0f : 1.0f;
        decGuideAcc += ((d == 'n') ? v : -v) * sky * ms / 1000.0f * DEC_STEPS_PER_DEG;
    } else {
        return false;
    }
    return true;
}

// Отправить ответ клиенту + дублировать в Serial
void lxSend(const String& s) {
    if (lxClientConnected && lxTcpClient.connected())
        lxTcpClient.print(s);
    Serial.print(F("  LX> ")); Serial.println(s);
}

// RA градусы → "HH:MM:SS#"  или  "HH:MM.T#"
// lx200driver использует getCommandSexa(:GR#) → ожидает HH:MM:SS или HH:MM.T
String lxFormatRA(double deg) {
    double h  = fmod(deg / 15.0, 24.0);
    if (h < 0.0) h += 24.0;
    int    hh  = (int)h;
    double rem = (h - hh) * 60.0;
    int    mm  = (int)rem;
    int    ss  = (int)((rem - mm) * 60.0);
    char   buf[20];
    if (lxHighPrecision)
        sprintf(buf, "%02d:%02d:%02d#", hh, mm, ss);
    else
        sprintf(buf, "%02d:%02d.%01d#", hh, mm, ss/6);
    return String(buf);
}

// RA градусы → "HH:MM:SS.SSSS#"  (для :GRH# / :GrH#)
String lxFormatRA_HP(double deg) {
    double h  = fmod(deg / 15.0, 24.0);
    if (h < 0.0) h += 24.0;
    int    hh  = (int)h;
    double rem = (h - hh) * 60.0;
    int    mm  = (int)rem;
    double ss  = (rem - mm) * 60.0;
    char   buf[24];
    sprintf(buf, "%02d:%02d:%07.4f#", hh, mm, ss);
    return String(buf);
}

// DEC градусы → "+DD*MM:SS#"  или  "+DD*MM#"
// lx200driver getCommandSexa(:GD#)
String lxFormatDEC(double deg) {
    char   sign = (deg >= 0) ? '+' : '-';
    double a    = fabs(deg);
    int    dd   = (int)a;
    double rem  = (a - dd) * 60.0;
    int    mm   = (int)rem;
    int    ss   = (int)((rem - mm) * 60.0);
    char   buf[20];
    if (lxHighPrecision)
        sprintf(buf, "%c%02d*%02d:%02d#", sign, dd, mm, ss);
    else
        sprintf(buf, "%c%02d*%02d#", sign, dd, mm);
    return String(buf);
}

// DEC градусы → "+DD*MM:SS.SSS#"  (для :GDH# и высокоточных)
String lxFormatDEC_HP(double deg) {
    char   sign = (deg >= 0) ? '+' : '-';
    double a    = fabs(deg);
    int    dd   = (int)a;
    double rem  = (a - dd) * 60.0;
    int    mm   = (int)rem;
    double ss   = (rem - mm) * 60.0;
    char   buf[24];
    sprintf(buf, "%c%02d*%02d:%06.3f#", sign, dd, mm, ss);
    return String(buf);
}

// Azimuth/Altitude → "DDD*MM'SS.SSS#"
String lxFormatAz(double deg) {
    double a  = fmod(fabs(deg), 360.0);
    int    dd = (int)a;
    double r  = (a - dd) * 60.0;
    int    mm = (int)r;
    double ss = (r - mm) * 60.0;
    char   buf[24];
    sprintf(buf, "%03d*%02d'%06.3f#", dd, mm, ss);
    return String(buf);
}

// Широта обсерватории → "+DD*MM:SS.SSS#"
// lx200driver getSiteLatitude(:Gt#) → sDD*MM:SS.SSS
String lxFormatLatitude(double deg) {
    char   sign = (deg >= 0) ? '+' : '-';
    double a    = fabs(deg);
    int    dd   = (int)a;
    double rem  = (a - dd) * 60.0;
    int    mm   = (int)rem;
    double ss   = (rem - mm) * 60.0;
    char   buf[24];
    sprintf(buf, "%c%02d*%02d:%06.3f#", sign, dd, mm, ss);
    return String(buf);
}

// Долгота обсерватории → "sDDD*MM:SS.SSS#"
// lx200driver getSiteLongitude(:Gg#): East = отрицательная!
// Наша obsLongitude_deg = East+, инвертируем для LX200
String lxFormatLongitude(double deg) {
    double lx   = -deg;   // East→West sign flip
    char   sign = (lx >= 0) ? '+' : '-';
    double a    = fabs(lx);
    int    dd   = (int)a;
    double rem  = (a - dd) * 60.0;
    int    mm   = (int)rem;
    double ss   = (rem - mm) * 60.0;
    char   buf[24];
    sprintf(buf, "%c%03d*%02d:%06.3f#", sign, dd, mm, ss);
    return String(buf);
}

// Парсинг RA из "HH:MM:SS" / "HH:MM:SS.SSS" / "HH:MM.T" → градусы
// lx200driver setObjectRA использует тот же формат
double lxParseRA(const String& s) {
    int c1 = s.indexOf(':');
    if (c1 < 0) return 0.0;
    int    hh = s.substring(0, c1).toInt();
    int    c2 = s.indexOf(':', c1+1);
    double mm, ss = 0.0;
    if (c2 > 0) {
        mm = s.substring(c1+1, c2).toDouble();
        ss = s.substring(c2+1).toDouble();
    } else {
        mm = s.substring(c1+1).toDouble();
    }
    return (hh + mm/60.0 + ss/3600.0) * 15.0;
}

// Парсинг DEC из "[s]DD*MM:SS" / "[s]DD*MM:SS.SSS" → градусы
double lxParseDEC(const String& s) {
    int  star = s.indexOf('*');
    if (star < 0) return s.toDouble();
    int  sgn  = (s.charAt(0) == '-') ? -1 : 1;
    int  st   = (s.charAt(0) == '+' || s.charAt(0) == '-') ? 1 : 0;
    int  dd   = s.substring(st, star).toInt();
    int  colon= s.indexOf(':', star+1);
    int  mm;
    double ss = 0.0;
    if (colon > 0) {
        mm = s.substring(star+1, colon).toInt();
        ss = s.substring(colon+1).toDouble();
    } else {
        mm = s.substring(star+1).toInt();
    }
    return sgn * (dd + mm/60.0 + ss/3600.0);
}

// Дней от 1970-01-01 до даты (григорианский календарь)
long daysFromCivil(int y, int m, int d) {
    y -= m <= 2;
    long era = (y >= 0 ? y : y - 399) / 400;
    long yoe = y - era * 400;
    long doy = (153 * (m + (m > 2 ? -3 : 9)) + 2) / 5 + d - 1;
    long doe = yoe * 365 + yoe / 4 - yoe / 100 + doy;
    return era * 146097 + doe - 719468;
}

// Местное время по смещению из :SG
void lxLocalTime(tm& t) {
    time_t lt = (time_t)(unixTimeNow() - lxUtcOffsetH * 3600.0);
    gmtime_r(&lt, &t);
}

// "HH:MM:SS#" (или с дробной частью для HP-варианта)
String lxFormatHMS(long secs, const char* frac) {
    secs = ((secs % 86400) + 86400) % 86400;
    char buf[24];
    sprintf(buf, "%02ld:%02ld:%02ld%s#", secs / 3600, (secs / 60) % 60, secs % 60, frac);
    return String(buf);
}

String lxLocalTimeStr(const char* frac) {
    tm t; lxLocalTime(t);
    return lxFormatHMS(t.tm_hour * 3600L + t.tm_min * 60 + t.tm_sec, frac);
}

String lxLocalDateStr() {
    tm t; lxLocalTime(t);
    char buf[12];
    sprintf(buf, "%02d/%02d/%02d#", t.tm_mon + 1, t.tm_mday, t.tm_year % 100);
    return String(buf);
}
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
