netkot/EQ2_mount/(commit log)

2026-08-16 Initial commit: EQ2 mount ESP8266 firmware and docs
2026-10-17 Add TMC2209 UART support on one-wire D4 bus
    - Firmware: TMCStepper over SoftwareSerial onewire on GPIO2 (57600),
    init of microsteps/current/StealthChop, periodic reconnect and reset
    recovery, /tmc diagnostics endpoint, ra_drv/dec_drv in /status.
    - Docs: one-wire UART on D4 instead of RX on D8 (D8 high at boot kept
    ESP8266 in SDIO boot mode), coil pair check at driver pins, VMOT bulk
    capacitor, RA hardware test results.
    - Move photos into images/, add TMC2209 soldering guide.
2026-10-17 Add TMC bus scan endpoint, document DEC bring-up
    - /tmc-scan: idle level of the UART line and reply per address 0-3,
    for diagnosing address conflicts and bus shorts.
    - Web UI: replace the A4988 heatsink warning with a TMC2209 one.
    - Docs: DEC verified, address-conflict symptoms (DEC MS1 on GND),
    stutter caused by polling /tmc during motion, RA read errors while
    its motor is energized, MS1/MS2 voltage check in the soldering guide.
2026-10-18 Label jog buttons with axes, record axis direction check
2026-10-18 Add NTP-based coordinate model (RA = LST - HA) with pier sides
    - Time from NTP, browser fallback (/set-time) or LX200 :SG/:SL/:SC
    - RA counter is now the mechanical hour angle; home = pole, counterweight
    down (HOME_HA_DEG = -90); GoTo picks the counterweight-down pier side,
    refines RA after the slew, refuses targets below the horizon
    - Separate slew (run) from tracking/jog (runSpeed): run() used to pull
    the axis back to the stale target, so tracking did not actually track
    - Real LST/time/date/alt-az in LX200, :St/:Sg site, fixed :Me/:Mw signs
    - DEC_STEPS_PER_DEG no longer truncated to 44
    - Jog buttons labelled by sky direction, LST/Alt/pier side in status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
2026-10-18 Add Polar Set button: home at the pole and fill pole coordinates
2026-10-18 Add button tooltips and help card, serve page from PROGMEM
    The page grew past what fits in RAM alongside the String copy that
    send() makes; send_P streams it from flash (RAM 76% -> 41%).
2026-10-20 Make the INDI LX200 OnStep driver work over the network
    - Answer the OnStep queries the driver polls (:%BD#, :%BR#, :GX95#,
    :GX96#, :A?#, :$QZ?#, :GXEM#, :GXY0#, focuser :FA#/:fA#/:FnA#).
    Over TCP it waits 2 s for each reply and aborts the poll on silence,
    so Ekos got no position or status.
    - :GU# in OnStep format (n/N, P/p, E, PEC '/', rate index, error code),
    slew rates :R0#..:R9# matching the driver's labels.
    - DEC jog is mechanical and wraps through the pole.
    - WiFi: STA only, modem sleep off, auto-reconnect.
    - /status reports build, uptime, RSSI and free heap; shown on the page.
2026-10-20 Persist the park position in flash, add diagonal slow-jog buttons
    - Set Park (was Set Home) and :hQ# save the current axis positions to
    flash. Park slews there and marks the mount parked only on arrival;
    :GU# reports I while parking. On boot the mount assumes it is at the
    saved park position and parked (home if none saved). Polar Set still
    declares home.
    - Fix a GoTo/Park that never finished after a jog: AccelStepper's
    moveTo() skips the speed computation when the target is unchanged,
    and runSpeed() jogging leaves the old target in place.
    - Diagonal slow-jog buttons drive both axes at once; DEC speed is scaled
    by cos(DEC) so the motion is at 45 degrees on the sky. /jog accepts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
2026-10-21 Add Sync/GoTo buttons for a ground landmark (antenna)
    The antenna on the neighbouring building is stored as fixed HA/DEC, so
    syncing to it or slewing to it works in daylight without stars or time.
    Both buttons turn tracking off; Sync also clears the parked flag.
2026-10-21 Fix inverted DEC after landmark Sync, make LX200 N/S sky-oriented
    Sync on the antenna picked the pier side nearest to the step counter,
    which could land on the through-the-pole side with the counterweight
    down: DEC+ then raised the tube while KStars showed it going down.
    It now chooses the side like GoTo does (counterweight below the RA axis).
    :Mn#/:Ms# now move north/south on the sky, inverted past the pole,
    the same as pulse guiding.
2026-10-31 Read the DEC Hall home sensor (A3144 on GPIO16)
    Debounced (5 ms) input on D0, reported in /status as hall, hall_raw,
    hall_edges and the mechanical DEC at the last zone entry/exit
    (hall_in/hall_out), shown in the web UI status line and logged to Serial.
    No home search yet.
2026-10-31 Find the DEC park mark with the Hall sensor
    The magnet sits in the park zone, not at the pole. /home-search drives DEC
    toward the stored mark (fast approach, back out, slow pass through the zone),
    takes the middle of the two edges and shifts the DEC counter to the mark;
    ?calibrate=1 measures the mark after a Sync and saves it to flash instead.
    RA is left alone; Stop, jog, Sync and E-Stop abort the search. Web UI buttons
    and status fields added. Document the sensor setup and the procedure.
2026-10-31 Draw the mount position from the side and from above
    New web UI card with two SVG views (from the west, and from above with
    north up) built from a 3D model of the mount: polar axis, counterweight
    and tube from the mechanical HA/DEC. Red arcs show Alt and Az (Az
    clockwise from north), the blue arrow shows where the tube points. While
    the axes move the page polls /status every 0.4 s. /status gains mech_ha
    and lat.
